rack-ten-compute/10-inch-homelab-computer/README.md

# 🖥️ RACK-10 — Сервер для 10-дюймовой стойки

> **Компактный серверный компьютер, разработанный для установки в 10-дюймовые стойки. Идеальное решение для хоум-лаб, edge-вычислений, NAS и домашней автоматизации.**




---

## 📋 Содержание

- [Описание](#-описание)
- [Области применения](#-основные-области-применения)
- [Технические характеристики](#-технические-характеристики)
- [Конфигурации](#-конфигурации)
- [Компоненты](#-компоненты)
- [Дорожная карта](#-дорожная-карта)
- [Лицензия](#-лицензия)

---

## 💡 Описание

**RACK-10** — это проект по разработке компактного серверного компьютера форм-фактора 10" (254 мм по ширине), который монтируется в стандартную 10-дюймовую раму (стойку). Устройство создано для энтузиастов, которым нужна производительная, но компактная вычислительная система для дома.

В отличие от громоздких 19-дюймовых серверов, RACK-10:

- Занимает вдвое меньше места по ширине
- Вписывается в интерьер (помещается в полку IKEA KALLAX)
- Сохраняет полную совместимость с сетевым и серверным оборудованием 10" формата

---

## 🎯 Основные области применения

| Область | Примеры использования |
|---|---|
| 🏠 **Хоум-лаб** | Кластер Proxmox, виртуализация, обучение |
| 💾 **NAS** | Домашнее облако, медиатека, бэкапы |
| 🔒 **Edge-вычисления** | Локальный AI, Frigate NVR, Coral TPU |
| 🏡 **Домашняя автоматизация** | Home Assistant, Zigbee/MQTT-брокер |
| 🌐 **Сетевая инфраструктура** | OPNsense/pfSense, роутер, DNS-сервер |

---

## 📐 Технические характеристики

| Параметр | Значение |
|---|---|
| **Форм-фактор** | 10" (совместимость с EIA-310) |
| **Ширина** | 254 мм (по стандарту) |
| **Высота** | 1U / 2U / 3U (на выбор) |
| **Глубина** | от 180 до 300 мм |
| **Платформа** | Advantech SOM-5871 — COM Express Basic Type 6, AMD Ryzen Embedded V1000 |
| **Охлаждение** | Активное / Пассивное (в зависимости от TDP) |
| **Питание** | DC 12V / 19V или ATX (PicoPSU) |

---

## 🚀 Конфигурации

Все конфигурации строятся на вычислительном модуле **Advantech SOM-5871**
(COM Express Basic Type 6) — AMD Ryzen Embedded V1000. Конфигурация меняется
выбором CPU (артикул модуля), ОЗУ и накопителей; несущая плата одна.

| Конфигурация | Модуль (CPU) | Ядер/потоков | TDP | ОЗУ |
|---|---|:---:|:---:|-----|
| **Эко (пассивное охлаждение)** | SOM-5871VC-U0A1 (V1605B) | 4/8 | 12–25 Вт | до 32 ГБ DDR4 |
| **Средняя** | SOM-5871VC-U3A1 (V1202B) / SOM-5871VCX-U1A1 (V1404I) | 2/4, 4/8 | 12–25 Вт | до 32 ГБ DDR4 |
| **Максимальная** | SOM-5871VC-H3A1 (V1807B) / SOM-5871VC-H2A1 (V1756B) | 4/8 | 35–54 Вт | до 32 ГБ DDR4 |

Общее для всех конфигураций:

- 2× SATA III (M.2 2280 Key B + U.2), PCIe x4 под NVMe/U.2 и x1 под M.2 M-Key
- 2× USB 3.1 Gen2 + 1× USB 3.1 Gen1 (все Type-A, Gen1 — с портом USB 2.0), 4× USB 2.0
- GbE (Intel I210-AT), dual-channel LVDS (2× FPC-40) + DisplayPort
- SMBus / I2C / SPI / WDT / FAN / GPIO — сервисные хедеры
- Питание: Vin 8.5–20 В (+ VSB 4.75–5.25 В в режиме ATX)

Подробности по интерфейсам — в [hw/README.md](hw/README.md).

---

## 🔧 Компоненты

- **Вычислительный модуль** — Advantech SOM-5871 (COM Express Basic Type 6,
  AMD Ryzen Embedded V1000), крепление — разъём COM Express Type 6
  (Molex [3-1827253-6](hw/bom/connectors/comexpress/3-1827253-6.pdf))
- **Несущая плата** — кастомная: M.2 2280 Key B, U.2, M.2 M-Key, 2× FPC-40
  (LVDS), RJ45, USB Type-A, HD Audio, сервисные пин-хедеры
  (GPIO/SPI/I2C/COM2)
- **ОЗУ** — 2× DDR4 SO-DIMM (на самом модуле)
- **Корпус** — 10" (254 мм), крепление в стойку EIA-310
- **Передняя панель** — опционально: порты USB, кнопка питания, LED-индикация
- **BOM** — каталог компонентов несущей платы: [hw/bom/README.md](hw/bom/README.md)

---

## 🗺️ Дорожная карта

- [x] Выбор вычислительного модуля (SOM-5871, AMD Ryzen Embedded V1000)
- [x] Спецификация интерфейсов несущей платы (сторона A/B и C/D)
- [x] BOM-каталог компонентов (первый компонент: разъём COM Express)
- [ ] Разработка несущей платы (схематика, разводка PCB)
- [ ] Прототип: SOM-5871VC-U0A1 + несущая плата
- [ ] Корпус 10" (CAD, 3D-печать / штамповка), крепление в стойку
- [ ] Блок питания (Vin 12–19 В, VSB)
- [ ] BIOS/UEFI-настройки, прошивки
- [ ] Файлы для 3D-печати корпуса (STL/STEP)
- [ ] Документация по сборке и эксплуатации

---

## Документация

- [docs/README.md](docs/README.md) — общая папка с доками;
  [docs/SOM-5871/README.md](docs/SOM-5871/README.md) — даташиты, user manual,
  application note, драйверы Windows 10, 3D-модели SOM-5871 + референсная плата
  SOM-DB5830 (схема, спецификация, разводка USB)

---

## 📄 Лицензия

Проект распространяется под лицензией MIT. Подробнее в файле [LICENSE](./LICENSE).

---

*Создано для энтузиастов хоум-лаб, DIY-сообщества и всех, кто хочет компактный сервер для дома*
