rack-ten-compute/10-inch-homelab-computer/hw/elec/README.md

# SOM-5871 — Электрическая спецификация

Источники:
- раздел **4 Electrical Characteristics** (Table 63–65) из
  [`docs/SOM-5871/design/SOM-5871 COM Express Type 6 Design Guide Rev110_220708.pdf`](../docs/SOM-5871/design/SOM-5871%20COM%20Express%20Type%206%20Design%20Guide%20Rev110_220708.pdf)
  — специфичен для SOM-5871;
- вкладка *Electrical Specifications* из
  [`docs/SOM-5871/design/SOM-5871 A101-3 COME Layout Checklist V1.01 20200604.xlsx`](../docs/SOM-5871/design/SOM-5871%20A101-3%20COME%20Layout%20Checklist%20V1.01%2020200604.xlsx)
  — общие требования COM Express Type 6 (440-pin): токи пинов,
  последовательность включения, время нарастания, целостность сигналов.

## Вводное питание

- Единственная основная шина — **+12 В** (номинал), допустимый диапазон
  **8,5–20 В** (Design Guide, Table 63: 8,5 = 9−5 % … 20 = 19+5 %).
- **+5 В standby (VCC_5V_SBY)** — может быть не подключена на несущей плате,
  если standby-функции не требуются.
- **+3 В батарея (VCC_RTC)** — питает RTC при отсутствии остальных источников;
  может быть оставлена незаземлённой, если RTC без питания не требуется.
- Переключение +5 В (non-standby) ATX-блока под модуль **не используется**
  (может применяться для остального оборудования несущей платы).
- Режимы питания: **ATX** (Vin + VSB) и **AT** (только Vin) — по
  спецификации SOM-DB5830; для ATX VSB обязательна.

Ограничения по току на пинах разъёма (Pin-out Type 2–56, 440 pin — актуально
для SOM-5871; Layout Checklist):

| Шина | Ток пина (А) | Номинал (В) | Диапазон входа (В) | Derated вход (В) | Макс. пульсации (мВ) | Макс. входная мощность (Вт) | КПД конверсии | Макс. мощность нагрузки (Вт) |
|:-----|:---:|:---:|:---:|:---:|:---:|:---:|:---:|:---:|
| VCC_12V | 16,5 | 12 | 11,4–12,6 | 11,4 | ±100 | 188 | 85 % | 160 |
| VCC_5V_SBY | 2 | 5 | 4,75–5,25 | 4,75 | ±50 | 9 | — | — |
| VCC_RTC | 0,5 | 3 | 2,0–3,3 | — | ±20 | — | — | — |

## Пределы абсолютных максимумов (Design Guide, Table 63)

| Параметр | MIN | MAX | Ед. |
|:---|:---:|:---:|:---:|
| VIN | 8,5 (9−5 %) | 20 (19+5 %) | В |
| VSB | 4,75 (5−5 %) | 5,25 (5+5 %) | В |
| RTC Battery | 2,4 | 3,3 | В |

## Потребление (Design Guide, Table 64)

Наихудший случай — V1807B (3.35 ГГц):

| Шина | S0 (TAT turbo, CPU 80 % + GPU 100 %) | S0 (Idle) | S3 | S5 | G3 |
|:-----|:---:|:---:|:--:|:--:|:--:|
| +VIN @ +12 В | 66,35 Вт | 11,14 Вт | — | — | — |
| +VIN @ +8,5 В | 64,32 Вт | 12,14 Вт | — | — | — |
| +VIN @ +20 В | 67,12 Вт | 15,00 Вт | — | — | — |
| +V5SB_CB | — | — | 1,34 Вт | 0,96 Вт | — |
| RTC Battery | — | — | — | — | 4,82 мкА |

> Примечание: S0 — режим Intel TAT, CPU All 100 % Turbo On.

## Ударные токи (Design Guide, Table 65)

| Шина | G3 → S5 (А) | S5 → S0 (А) |
|:-----|:---:|:---:|
| +V5SB_CB | 1,04 | — |
| +VIN @ +12 В | — | 5,20 |
| +VIN @ +8,5 В | — | 7,40 |
| +VIN @ +20 В | — | 3,27 |

> Блок питания несущей платы и предохранители подбирать с учётом
> максимального ударного тока 7,4 А (при питании 8,5 В).

## Последовательность включения (power sequencing)

- VCC_RTC — включается одновременно с VCC_5V_SBY или раньше.
- VCC_5V_SBY — одновременно с VCC_12V или раньше.
- PWR_OK — активен одновременно с VCC_12V или позже.
- Падение: PWR_OK сбрасывается одновременно с VCC_12V или раньше;
  VCC_12V — одновременно с VCC_5V_SBY или раньше; VCC_5V_SBY — одновременно
  с VCC_RTC или раньше.

| Т | Интервал | Требование |
|:-:|:---|:---|
| T1 | включение VCC_RTC → включение VCC_5V_SBY | ≥ 0 мс |
| T2 | включение VCC_5V_SBY → включение VCC_12V | ≥ 0 мс |
| T3 | включение VCC_12V → PWR_OK | ≥ 0 мс |
| T4 | сброс PWR_OK → сброс VCC_12V | ≥ 0 мс |
| T5 | сброс VCC_12V → сброс VCC_5V_SBY | ≥ 0 мс |
| T6 | сброс VCC_5V_SBY → сброс VCC_RTC | ≥ 0 мс |

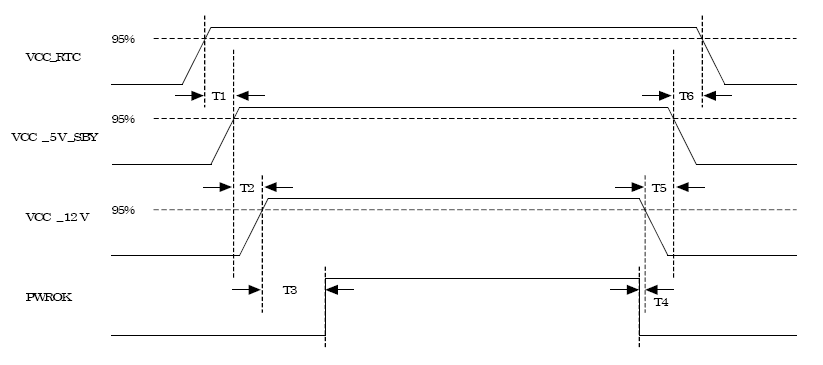
[picture p5: hw/elec/elec-power-sequencing.png]
Power Sequencing


## Время нарастания питающих напряжений

VCC_12V и VCC_5V_SBY (если используется) должны нарастать с ≤ 10 % номинала
до рабочего диапазона за **0,1–20 мс** (0,1 мс ≤ T1 ≤ 20 мс):

- плавный непрерывный фронт 10–90 % в пределах рабочего диапазона;
- на участке 10–90 % наклон положительный: от 0 В/мс до [Vout,nom / 0,1] В/мс;
- на любом участке 5 мс внутри фронта 10–90 % наклон ≥ [Vout,nom / 20] В/мс.

T2 ≥ 0 мс, T3 ≥ 0 мс. Значения подобраны для совместимости с ATX R2.2.

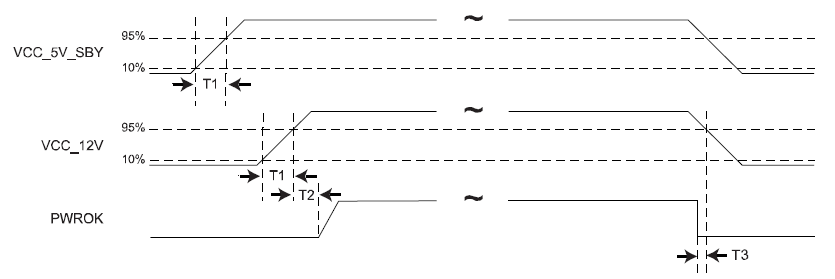
[picture p6: hw/elec/elec-power-rise-time.png]
Input Power Rise Time


## Требования к целостности сигналов

Для проектирования модуля и несущей платы учесть следующие группы сигналов
(полные требования — в соответствующих спецификациях интерфейсов):

| Группа сигналов | Описание | Источник |
|:---|:---|:---|
| Аналоговый VGA | 75 Ом, однополярные относительно GND; рекомендуется обильная изоляция | — |
| Компонентное/композитное видео | 75 Ом, однополярные относительно GND; рекомендуется обильная изоляция | — |
| Gigabit Ethernet | дифференциальные пары | IEEE 802.3 |
| LVDS | 100 Ом, edge-coupled дифференциальные пары | National Semiconductor LVDS |
| PCI Bus | ~60 Ом, однополярные | PCI SIG, PCI Local Bus Spec Rev. 2.3 |
| Часы PCI/LPC | 50 Ом, однополярные относительно GND | — |
| PCI Express | дифференциальные пары | PCI SIG, PCI Express Specification |
| Часы PCI Express | 100 Ом, edge-coupled дифференциальная пара, относительно GND | — |
| Serial ATA | дифференциальные пары | SATA Specification |
| USB | дифференциальные пары | USB 2.0 Specification |

> **Примечание:** VGA на SOM-5871 не выводится на несущую плату
> (см. [../pinout.md](../pinout.md), сводку по группам) — требования по VGA
> актуальны только для модуля.
