rack-ten-compute/10-inch-homelab-computer/hw/sch/pinout/comexpress-abcd.md

[FILE A]
A1 - GND_FIXED_1
A2 - GBE0_MDI3-
A3 - GBE0_MDI3+
A4 - GBE0_LINK100#
A5 - GBE0_LINK1000#
A6 - GBE0_MDI2-
A7 - GBE0_MDI2+
A8 - GBE0_LINK#
A9 - GBE0_MDI1-
A10 - GBE0_MDI1+
A11 - GND_FIXED_2
A12 - GBE0_MDI0-
A13 - GBE0_MDI0+
A14 - GBE0_CTREF
A15 - SUS_S3#
A16 - SATA0_TX+
A17 - SATA0_TX-
A18 - SUS_S4#
A19 - SATA0_RX+
A20 - SATA0_RX-
A21 - GND_FIXED_3
A22 - SATA2_TX+
A23 - SATA2_TX-
A24 - SUS_S5#
A25 - SATA2_RX+
A26 - SATA2_RX-
A27 - BATLOW#
A28 - SATA_ACT#
A29 - HDA_SYNC
A30 - HDA_RST#
A31 - GND_FIXED_4
A32 - HDA_BITCLK
A33 - HDA_SDOUT
A34 - BIOS_DIS0#/ESPI_SAFS
A35 - THRMTRIP#
A36 - USB6-
A37 - USB6+
A38 - USB_6_7_OC#
A39 - USB4-
A40 - USB4+
A41 - GND_FIXED_5
A42 - USB2-
A43 - USB2+
A44 - USB_2_3_OC#
A45 - USB0-
A46 - USB0+
A47 - VCC_RTC
A48 - RSMRST_OUT#
A49 - GBE0_SDP
A50 - LPC_SERIRQ/ESPI_CS1#
A51 - GND_FIXED_6
A52 - PCIE_TX5+
A53 - PCIE_TX5-
A54 - GPI0
A55 - PCIE_TX4+
A56 - PCIE_TX4-
A57 - GND_1
A58 - PCIE_TX3+
A59 - PCIE_TX3-
A60 - GND_FIXED_7
A61 - PCIE_TX2+
A62 - PCIE_TX2-
A63 - GPI1
A64 - PCIE_TX1+
A65 - PCIE_TX1-
A66 - GND_10
A67 - GPI2
A68 - PCIE_TX0+
A69 - PCIE_TX0-
A70 - GND_FIXED_8
A71 - LVDS_A0+
A72 - LVDS_A0-
A73 - LVDS_A1+
A74 - LVDS_A1-
A75 - LVDS_A2+
A76 - LVDS_A2-
A77 - LVDS_VDD_EN
A78 - LVDS_A3+
A79 - LVDS_A3-
A80 - GND_FIXED_9
A81 - LVDS_A_CK+
A82 - LVDS_A_CK-
A83 - LVDS_I2C_CK
A84 - LVDS_I2C_DAT
A85 - GPI3
A86 - GP_SPI_MOSI
A87 - EDP_HPD
A88 - PCIE_CK_REF+
A89 - PCIE_CK_REF-
A90 - GND_FIXED_10
A91 - SPI_POWER
A92 - SPI_MISO
A93 - GPO0
A94 - SPI_CLK
A95 - SPI_MOSI
A96 - TPM_PP
A97 - TYPE10#
A98 - SER0_TX
A99 - SER0_RX
A100 - GND_FIXED_11
A101 - SER1_TX
A102 - SER1_RX
A103 - LID#
A104 - VCC_12V_1
A105 - VCC_12V_2
A106 - VCC_12V_3
A107 - VCC_12V_4
A108 - VCC_12V_5
A109 - VCC_12V_6
A110 - GND_FIXED_12

[FILE B]
B1 - GND_FIXED_13
B2 - GBE0_ACT#
B3 - LPC_FRAME#/ESPI_CS0#
B4 - LPC_AD0/ESPI_IO_0
B5 - LPC_AD1/ESPI_IO_1
B6 - LPC_AD2/ESPI_IO_2
B7 - LPC_AD3/ESPI_IO_3
B8 - LPC_DRQ0#/ESPI_ALERT0#
B9 - LPC_DRQ1#/ESPI_ALERT1#
B10 - LPC_CLK/ESPI_CK
B11 - GND_FIXED_14
B12 - PWRBTN#
B13 - SMB_CK
B14 - SMB_DAT
B15 - SMB_ALERT#
B16 - SATA1_TX+
B17 - SATA1_TX-
B18 - SUS_STAT#/ESPI_RESET#
B19 - SATA1_RX+
B20 - SATA1_RX-
B21 - GND_FIXED_15
B22 - SATA3_TX+
B23 - SATA3_TX-
B24 - PWR_OK
B25 - SATA3_RX+
B26 - SATA3_RX-
B27 - WDT
B28 - HDA_SDIN2/SNDW0_CLK
B29 - HDA_SDIN1/SNDW0_DAT
B30 - HDA_SDIN0
B31 - GND_FIXED_16
B32 - SPKR
B33 - I2C_CK
B34 - I2C_DAT
B35 - THRM#
B36 - USB7-
B37 - USB7+
B38 - USB_4_5_OC#
B39 - USB5-
B40 - USB5+
B41 - GND_FIXED_17
B42 - USB3-
B43 - USB3+
B44 - USB_0_1_OC#
B45 - USB1-
B46 - USB1+
B47 - ESPI_EN#
B48 - USB0_HOST_PRSNT
B49 - SYS_RESET#
B50 - CB_RESET#
B51 - GND_FIXED_18
B52 - PCIE_RX5+
B53 - PCIE_RX5-
B54 - GPO1
B55 - PCIE_RX4+
B56 - PCIE_RX4-
B57 - GPO2
B58 - PCIE_RX3+
B59 - PCIE_RX3-
B60 - GND_FIXED_19
B61 - PCIE_RX2+
B62 - PCIE_RX2-
B63 - GPO3
B64 - PCIE_RX1+
B65 - PCIE_RX1-
B66 - WAKE0#
B67 - WAKE1#
B68 - PCIE_RX0+
B69 - PCIE_RX0-
B70 - GND_FIXED_20
B71 - LVDS_B0+
B72 - LVDS_B0-
B73 - LVDS_B1+
B74 - LVDS_B1-
B75 - LVDS_B2+
B76 - LVDS_B2-
B77 - LVDS_B3+
B78 - LVDS_B3-
B79 - LVDS_BKLT_EN
B80 - GND_FIXED_21
B81 - LVDS_B_CK+
B82 - LVDS_B_CK-
B83 - LVDS_BKLT_CTRL
B84 - VCC_5V_SBY_1
B85 - VCC_5V_SBY_2
B86 - VCC_5V_SBY_3
B87 - VCC_5V_SBY_4
B88 - BIOS_DIS1#
B89 - VGA_RED
B90 - GND_FIXED_22
B91 - VGA_GRN
B92 - VGA_BLU
B93 - VGA_HSYNC
B94 - VGA_VSYNC
B95 - VGA_I2C_CK
B96 - VGA_I2C_DAT
B97 - SPI_CS#
B98 - GP_SPI_MISO
B99 - GP_SPI_CK
B100 - GND_FIXED_23
B101 - FAN_PWMOUT
B102 - FAN_TACHIN
B103 - SLEEP#
B104 - VCC_12V_7
B105 - VCC_12V_8
B106 - VCC_12V_9
B107 - VCC_12V_10
B108 - VCC_12V_11
B109 - VCC_12V_12
B110 - GND_FIXED_24

[FILE C]
C1 - GND_FIXED_25
C2 - GND_11
C3 - USB_SSRX0-
C4 - USB_SSRX0+
C5 - GND_12
C6 - USB_SSRX1-
C7 - USB_SSRX1+
C8 - GND_13
C9 - USB_SSRX2-
C10 - USB_SSRX2+
C11 - GND_FIXED_26
C12 - USB_SSRX3-
C13 - USB_SSRX3+
C14 - GND_14
C15 - USB4_1_LSTX
C16 - USB4_1_LSRX
C17 - USB4_RT_ENA
C18 - GND_15
C19 - PCIE_RX6+
C20 - PCIE_RX6-
C21 - GND_FIXED_27
C22 - PCIE_RX7+
C23 - PCIE_RX7-
C24 - DDI1_HPD
C25 - SML0_CLK
C26 - SML0_DAT
C27 - SML1_CLK
C28 - SML1_DAT
C29 - USB4_PD_I2C_CLK
C30 - USB4_PD_I2C_DAT
C31 - GND_FIXED_28
C32 - DDI2_CTRLCLK_AUX+/USB4_2_AUX+
C33 - DDI2_CTRLDATA_AUX-/USB4_2_AUX-
C34 - DDI2_DDC_AUX_SEL
C35 - USB4_2_LSTX
C36 - DDI3_CTRLCLK_AUX+
C37 - DDI3_CTRLDATA_AUX-
C38 - DDI3_DDC_AUX_SEL
C39 - DDI3_PAIR0+
C40 - DDI3_PAIR0-
C41 - GND_FIXED_29
C42 - DDI3_PAIR1+
C43 - DDI3_PAIR1-
C44 - DDI3_HPD
C45 - GP_SPI_CS#
C46 - DDI3_PAIR2+
C47 - DDI3_PAIR2-
C48 - RSVD10_10
C49 - DDI3_PAIR3+
C50 - DDI3_PAIR3-
C51 - GND_FIXED_30
C52 - PEG_RX0+
C53 - PEG_RX0-
C54 - TYPE0#
C55 - PEG_RX1+
C56 - PEG_RX1-
C57 - TYPE1#
C58 - PEG_RX2+
C59 - PEG_RX2-
C60 - GND_FIXED_31
C61 - PEG_RX3+
C62 - PEG_RX3-
C63 - GND_3
C64 - GND_30
C65 - PEG_RX4+
C66 - PEG_RX4-
C67 - RAPID_SHUTDOWN
C68 - PEG_RX5+
C69 - PEG_RX5-
C70 - GND_FIXED_32
C71 - PEG_RX6+
C72 - PEG_RX6-
C73 - GND_31
C74 - PEG_RX7+
C75 - PEG_RX7-
C76 - GND_32
C77 - GND_33
C78 - PEG_RX8+
C79 - PEG_RX8-
C80 - GND_FIXED_33
C81 - PEG_RX9+
C82 - PEG_RX9-
C83 - GND_34
C84 - GND_35
C85 - PEG_RX10+
C86 - PEG_RX10-
C87 - GND_36
C88 - PEG_RX11+
C89 - PEG_RX11-
C90 - GND_FIXED_34
C91 - PEG_RX12+
C92 - PEG_RX12-
C93 - GND_37
C94 - PEG_RX13+
C95 - PEG_RX13-
C96 - GND_38
C97 - GND_39
C98 - PEG_RX14+
C99 - PEG_RX14-
C100 - GND_FIXED_35
C101 - PEG_RX15+
C102 - PEG_RX15-
C103 - GND_8
C104 - VCC_12V_13
C105 - VCC_12V_14
C106 - VCC_12V_15
C107 - VCC_12V_16
C108 - VCC_12V_17
C109 - VCC_12V_18
C110 - GND_FIXED_36

[FILE D]
D1 - GND_FIXED_37
D2 - GND_16
D3 - USB_SSTX0-
D4 - USB_SSTX0+
D5 - GND_17
D6 - USB_SSTX1-
D7 - USB_SSTX1+
D8 - GND_18
D9 - USB_SSTX2-
D10 - USB_SSTX2+
D11 - GND_FIXED_38
D12 - USB_SSTX3-
D13 - USB_SSTX3+
D14 - GND_19
D15 - DDI1_CTRLCLK_AUX+/USB4_1_AUX+
D16 - DDI1_CTRLDATA_AUX-/USB4_1_AUX-
D17 - USB4_PD_I2C_ALERT#
D18 - PMCALERT#
D19 - PCIE_TX6+
D20 - PCIE_TX6-
D21 - GND_FIXED_39
D22 - PCIE_TX7+
D23 - PCIE_TX7-
D24 - GND_2
D25 - GND_20
D26 - DDI1_PAIR0+/USB4_1_SSTX0+
D27 - DDI1_PAIR0-/USB4_1_SSTX0-
D28 - RSVD10_20
D29 - DDI1_PAIR1+/USB4_1_SSRX0+
D30 - DDI1_PAIR1-/USB4_1_SSRX0-
D31 - GND_FIXED_40
D32 - DDI1_PAIR2+/USB4_1_SSTX1+
D33 - DDI1_PAIR2-/USB4_1_SSTX1-
D34 - DDI1_DDC_AUX_SEL
D35 - USB4_2_LSRX
D36 - DDI1_PAIR3+/USB4_1_SSRX1+
D37 - DDI1_PAIR3-/USB4_1_SSRX1-
D38 - GND_21
D39 - DDI2_PAIR0+/USB4_2_SSTX0+
D40 - DDI2_PAIR0-/USB4_2_SSTX0-
D41 - GND_FIXED_41
D42 - DDI2_PAIR1+/USB4_2_SSRX0+
D43 - DDI2_PAIR1-/USB4_2_SSRX0-
D44 - DDI2_HPD
D45 - GND_22
D46 - DDI2_PAIR2+/USB4_2_SSTX1+
D47 - DDI2_PAIR2-/USB4_2_SSTX1-
D48 - GND_23
D49 - DDI2_PAIR3+/USB4_2_SSRX1+
D50 - DDI2_PAIR3-/USB4_2_SSRX1-
D51 - GND_FIXED_42
D52 - PEG_TX0+
D53 - PEG_TX0-
D54 - PEG_LANE_RV#
D55 - PEG_TX1+
D56 - PEG_TX1-
D57 - TYPE2#
D58 - PEG_TX2+
D59 - PEG_TX2-
D60 - GND_FIXED_43
D61 - PEG_TX3+
D62 - PEG_TX3-
D63 - GND_24
D64 - GND_25
D65 - PEG_TX4+
D66 - PEG_TX4-
D67 - GND_26
D68 - PEG_TX5+
D69 - PEG_TX5-
D70 - GND_FIXED_44
D71 - PEG_TX6+
D72 - PEG_TX6-
D73 - GND_27
D74 - PEG_TX7+
D75 - PEG_TX7-
D76 - GND_28
D77 - GND_29
D78 - PEG_TX8+
D79 - PEG_TX8-
D80 - GND_FIXED_45
D81 - PEG_TX9+
D82 - PEG_TX9-
D83 - GND_4
D84 - GND_40
D85 - PEG_TX10+
D86 - PEG_TX10-
D87 - GND_41
D88 - PEG_TX11+
D89 - PEG_TX11-
D90 - GND_FIXED_46
D91 - PEG_TX12+
D92 - PEG_TX12-
D93 - GND_5
D94 - PEG_TX13+
D95 - PEG_TX13-
D96 - GND_6
D97 - GND_7
D98 - PEG_TX14+
D99 - PEG_TX14-
D100 - GND_FIXED_47
D101 - PEG_TX15+
D102 - PEG_TX15-
D103 - GND_9
D104 - VCC_12V_19
D105 - VCC_12V_20
D106 - VCC_12V_21
D107 - VCC_12V_22
D108 - VCC_12V_23
D109 - VCC_12V_24
D110 - GND_FIXED_48
