rack-ten-compute/10-inch-homelab-computer/docs/SOM-5871/win10-driver/cloud-mail-link.md

https://cloud.mail.ru/public/WeKb/FmAMsSqu3
https://www.advantech.com/emt/support/details/driver-?id=1-1P332Z7
