rack-ten-compute/10-inch-homelab-computer/hw/sch/pinout/comexpress-abcd-pinout.xlsx

Sheet: A
Pin | Ball | Type | Side
GND_FIXED_1 | A1 | GND | LEFT
GBE0_MDI3- | A2 | BIDIR | LEFT
GBE0_MDI3+ | A3 | BIDIR | LEFT
GBE0_LINK100# | A4 | BIDIR | LEFT
GBE0_LINK1000# | A5 | BIDIR | LEFT
GBE0_MDI2- | A6 | BIDIR | LEFT
GBE0_MDI2+ | A7 | BIDIR | LEFT
GBE0_LINK# | A8 | BIDIR | LEFT
GBE0_MDI1- | A9 | BIDIR | LEFT
GBE0_MDI1+ | A10 | BIDIR | LEFT
GND_FIXED_2 | A11 | GND | LEFT
GBE0_MDI0- | A12 | BIDIR | LEFT
GBE0_MDI0+ | A13 | BIDIR | LEFT
GBE0_CTREF | A14 | BIDIR | LEFT
SUS_S3# | A15 | BIDIR | LEFT
SATA0_TX+ | A16 | BIDIR | LEFT
SATA0_TX- | A17 | BIDIR | LEFT
SUS_S4# | A18 | BIDIR | LEFT
SATA0_RX+ | A19 | BIDIR | LEFT
SATA0_RX- | A20 | BIDIR | LEFT
GND_FIXED_3 | A21 | GND | LEFT
SATA2_TX+ | A22 | BIDIR | LEFT
SATA2_TX- | A23 | BIDIR | LEFT
SUS_S5# | A24 | BIDIR | LEFT
SATA2_RX+ | A25 | BIDIR | LEFT
SATA2_RX- | A26 | BIDIR | LEFT
BATLOW# | A27 | BIDIR | LEFT
SATA_ACT# | A28 | BIDIR | LEFT
HDA_SYNC | A29 | BIDIR | LEFT
HDA_RST# | A30 | BIDIR | LEFT
GND_FIXED_4 | A31 | GND | LEFT
HDA_BITCLK | A32 | BIDIR | LEFT
HDA_SDOUT | A33 | BIDIR | LEFT
BIOS_DIS0#/ESPI_SAFS | A34 | BIDIR | LEFT
THRMTRIP# | A35 | BIDIR | LEFT
USB6- | A36 | BIDIR | LEFT
USB6+ | A37 | BIDIR | LEFT
USB_6_7_OC# | A38 | BIDIR | LEFT
USB4- | A39 | BIDIR | LEFT
USB4+ | A40 | BIDIR | LEFT
GND_FIXED_5 | A41 | GND | LEFT
USB2- | A42 | BIDIR | LEFT
USB2+ | A43 | BIDIR | LEFT
USB_2_3_OC# | A44 | BIDIR | LEFT
USB0- | A45 | BIDIR | LEFT
USB0+ | A46 | BIDIR | LEFT
VCC_RTC | A47 | PWR | LEFT
RSMRST_OUT# | A48 | BIDIR | LEFT
GBE0_SDP | A49 | BIDIR | LEFT
LPC_SERIRQ/ESPI_CS1# | A50 | BIDIR | LEFT
GND_FIXED_6 | A51 | GND | LEFT
PCIE_TX5+ | A52 | BIDIR | LEFT
PCIE_TX5- | A53 | BIDIR | LEFT
GPI0 | A54 | BIDIR | LEFT
PCIE_TX4+ | A55 | BIDIR | LEFT
PCIE_TX4- | A56 | BIDIR | LEFT
GND_1 | A57 | GND | LEFT
PCIE_TX3+ | A58 | BIDIR | LEFT
PCIE_TX3- | A59 | BIDIR | LEFT
GND_FIXED_7 | A60 | GND | LEFT
PCIE_TX2+ | A61 | BIDIR | LEFT
PCIE_TX2- | A62 | BIDIR | LEFT
GPI1 | A63 | BIDIR | LEFT
PCIE_TX1+ | A64 | BIDIR | LEFT
PCIE_TX1- | A65 | BIDIR | LEFT
GND_10 | A66 | GND | LEFT
GPI2 | A67 | BIDIR | LEFT
PCIE_TX0+ | A68 | BIDIR | LEFT
PCIE_TX0- | A69 | BIDIR | LEFT
GND_FIXED_8 | A70 | GND | LEFT
LVDS_A0+ | A71 | BIDIR | LEFT
LVDS_A0- | A72 | BIDIR | LEFT
LVDS_A1+ | A73 | BIDIR | LEFT
LVDS_A1- | A74 | BIDIR | LEFT
LVDS_A2+ | A75 | BIDIR | LEFT
LVDS_A2- | A76 | BIDIR | LEFT
LVDS_VDD_EN | A77 | BIDIR | LEFT
LVDS_A3+ | A78 | BIDIR | LEFT
LVDS_A3- | A79 | BIDIR | LEFT
GND_FIXED_9 | A80 | GND | LEFT
LVDS_A_CK+ | A81 | BIDIR | LEFT
LVDS_A_CK- | A82 | BIDIR | LEFT
LVDS_I2C_CK | A83 | BIDIR | LEFT
LVDS_I2C_DAT | A84 | BIDIR | LEFT
GPI3 | A85 | BIDIR | LEFT
GP_SPI_MOSI | A86 | BIDIR | LEFT
EDP_HPD | A87 | BIDIR | LEFT
PCIE_CK_REF+ | A88 | BIDIR | LEFT
PCIE_CK_REF- | A89 | BIDIR | LEFT
GND_FIXED_10 | A90 | GND | LEFT
SPI_POWER | A91 | BIDIR | LEFT
SPI_MISO | A92 | BIDIR | LEFT
GPO0 | A93 | BIDIR | LEFT
SPI_CLK | A94 | BIDIR | LEFT
SPI_MOSI | A95 | BIDIR | LEFT
TPM_PP | A96 | BIDIR | LEFT
TYPE10# | A97 | BIDIR | LEFT
SER0_TX | A98 | BIDIR | LEFT
SER0_RX | A99 | BIDIR | LEFT
GND_FIXED_11 | A100 | GND | LEFT
SER1_TX | A101 | BIDIR | LEFT
SER1_RX | A102 | BIDIR | LEFT
LID# | A103 | BIDIR | LEFT
VCC_12V_1 | A104 | PWR | LEFT
VCC_12V_2 | A105 | PWR | LEFT
VCC_12V_3 | A106 | PWR | LEFT
VCC_12V_4 | A107 | PWR | LEFT
VCC_12V_5 | A108 | PWR | LEFT
VCC_12V_6 | A109 | PWR | LEFT
GND_FIXED_12 | A110 | GND | LEFT

Sheet: B
Pin | Ball | Type | Side
GND_FIXED_13 | B1 | GND | RIGHT
GBE0_ACT# | B2 | BIDIR | RIGHT
LPC_FRAME#/ESPI_CS0# | B3 | BIDIR | RIGHT
LPC_AD0/ESPI_IO_0 | B4 | BIDIR | RIGHT
LPC_AD1/ESPI_IO_1 | B5 | BIDIR | RIGHT
LPC_AD2/ESPI_IO_2 | B6 | BIDIR | RIGHT
LPC_AD3/ESPI_IO_3 | B7 | BIDIR | RIGHT
LPC_DRQ0#/ESPI_ALERT0# | B8 | BIDIR | RIGHT
LPC_DRQ1#/ESPI_ALERT1# | B9 | BIDIR | RIGHT
LPC_CLK/ESPI_CK | B10 | BIDIR | RIGHT
GND_FIXED_14 | B11 | GND | RIGHT
PWRBTN# | B12 | BIDIR | RIGHT
SMB_CK | B13 | BIDIR | RIGHT
SMB_DAT | B14 | BIDIR | RIGHT
SMB_ALERT# | B15 | BIDIR | RIGHT
SATA1_TX+ | B16 | BIDIR | RIGHT
SATA1_TX- | B17 | BIDIR | RIGHT
SUS_STAT#/ESPI_RESET# | B18 | BIDIR | RIGHT
SATA1_RX+ | B19 | BIDIR | RIGHT
SATA1_RX- | B20 | BIDIR | RIGHT
GND_FIXED_15 | B21 | GND | RIGHT
SATA3_TX+ | B22 | BIDIR | RIGHT
SATA3_TX- | B23 | BIDIR | RIGHT
PWR_OK | B24 | BIDIR | RIGHT
SATA3_RX+ | B25 | BIDIR | RIGHT
SATA3_RX- | B26 | BIDIR | RIGHT
WDT | B27 | BIDIR | RIGHT
HDA_SDIN2/SNDW0_CLK | B28 | BIDIR | RIGHT
HDA_SDIN1/SNDW0_DAT | B29 | BIDIR | RIGHT
HDA_SDIN0 | B30 | BIDIR | RIGHT
GND_FIXED_16 | B31 | GND | RIGHT
SPKR | B32 | BIDIR | RIGHT
I2C_CK | B33 | BIDIR | RIGHT
I2C_DAT | B34 | BIDIR | RIGHT
THRM# | B35 | BIDIR | RIGHT
USB7- | B36 | BIDIR | RIGHT
USB7+ | B37 | BIDIR | RIGHT
USB_4_5_OC# | B38 | BIDIR | RIGHT
USB5- | B39 | BIDIR | RIGHT
USB5+ | B40 | BIDIR | RIGHT
GND_FIXED_17 | B41 | GND | RIGHT
USB3- | B42 | BIDIR | RIGHT
USB3+ | B43 | BIDIR | RIGHT
USB_0_1_OC# | B44 | BIDIR | RIGHT
USB1- | B45 | BIDIR | RIGHT
USB1+ | B46 | BIDIR | RIGHT
ESPI_EN# | B47 | BIDIR | RIGHT
USB0_HOST_PRSNT | B48 | BIDIR | RIGHT
SYS_RESET# | B49 | BIDIR | RIGHT
CB_RESET# | B50 | BIDIR | RIGHT
GND_FIXED_18 | B51 | GND | RIGHT
PCIE_RX5+ | B52 | BIDIR | RIGHT
PCIE_RX5- | B53 | BIDIR | RIGHT
GPO1 | B54 | BIDIR | RIGHT
PCIE_RX4+ | B55 | BIDIR | RIGHT
PCIE_RX4- | B56 | BIDIR | RIGHT
GPO2 | B57 | BIDIR | RIGHT
PCIE_RX3+ | B58 | BIDIR | RIGHT
PCIE_RX3- | B59 | BIDIR | RIGHT
GND_FIXED_19 | B60 | GND | RIGHT
PCIE_RX2+ | B61 | BIDIR | RIGHT
PCIE_RX2- | B62 | BIDIR | RIGHT
GPO3 | B63 | BIDIR | RIGHT
PCIE_RX1+ | B64 | BIDIR | RIGHT
PCIE_RX1- | B65 | BIDIR | RIGHT
WAKE0# | B66 | BIDIR | RIGHT
WAKE1# | B67 | BIDIR | RIGHT
PCIE_RX0+ | B68 | BIDIR | RIGHT
PCIE_RX0- | B69 | BIDIR | RIGHT
GND_FIXED_20 | B70 | GND | RIGHT
LVDS_B0+ | B71 | BIDIR | RIGHT
LVDS_B0- | B72 | BIDIR | RIGHT
LVDS_B1+ | B73 | BIDIR | RIGHT
LVDS_B1- | B74 | BIDIR | RIGHT
LVDS_B2+ | B75 | BIDIR | RIGHT
LVDS_B2- | B76 | BIDIR | RIGHT
LVDS_B3+ | B77 | BIDIR | RIGHT
LVDS_B3- | B78 | BIDIR | RIGHT
LVDS_BKLT_EN | B79 | BIDIR | RIGHT
GND_FIXED_21 | B80 | GND | RIGHT
LVDS_B_CK+ | B81 | BIDIR | RIGHT
LVDS_B_CK- | B82 | BIDIR | RIGHT
LVDS_BKLT_CTRL | B83 | BIDIR | RIGHT
VCC_5V_SBY_1 | B84 | PWR | RIGHT
VCC_5V_SBY_2 | B85 | PWR | RIGHT
VCC_5V_SBY_3 | B86 | PWR | RIGHT
VCC_5V_SBY_4 | B87 | PWR | RIGHT
BIOS_DIS1# | B88 | BIDIR | RIGHT
VGA_RED | B89 | BIDIR | RIGHT
GND_FIXED_22 | B90 | GND | RIGHT
VGA_GRN | B91 | BIDIR | RIGHT
VGA_BLU | B92 | BIDIR | RIGHT
VGA_HSYNC | B93 | BIDIR | RIGHT
VGA_VSYNC | B94 | BIDIR | RIGHT
VGA_I2C_CK | B95 | BIDIR | RIGHT
VGA_I2C_DAT | B96 | BIDIR | RIGHT
SPI_CS# | B97 | BIDIR | RIGHT
GP_SPI_MISO | B98 | BIDIR | RIGHT
GP_SPI_CK | B99 | BIDIR | RIGHT
GND_FIXED_23 | B100 | GND | RIGHT
FAN_PWMOUT | B101 | BIDIR | RIGHT
FAN_TACHIN | B102 | BIDIR | RIGHT
SLEEP# | B103 | BIDIR | RIGHT
VCC_12V_7 | B104 | PWR | RIGHT
VCC_12V_8 | B105 | PWR | RIGHT
VCC_12V_9 | B106 | PWR | RIGHT
VCC_12V_10 | B107 | PWR | RIGHT
VCC_12V_11 | B108 | PWR | RIGHT
VCC_12V_12 | B109 | PWR | RIGHT
GND_FIXED_24 | B110 | GND | RIGHT

Sheet: C
Pin | Ball | Type | Side
GND_FIXED_25 | C1 | GND | LEFT
GND_11 | C2 | GND | LEFT
USB_SSRX0- | C3 | BIDIR | LEFT
USB_SSRX0+ | C4 | BIDIR | LEFT
GND_12 | C5 | GND | LEFT
USB_SSRX1- | C6 | BIDIR | LEFT
USB_SSRX1+ | C7 | BIDIR | LEFT
GND_13 | C8 | GND | LEFT
USB_SSRX2- | C9 | BIDIR | LEFT
USB_SSRX2+ | C10 | BIDIR | LEFT
GND_FIXED_26 | C11 | GND | LEFT
USB_SSRX3- | C12 | BIDIR | LEFT
USB_SSRX3+ | C13 | BIDIR | LEFT
GND_14 | C14 | GND | LEFT
USB4_1_LSTX | C15 | BIDIR | LEFT
USB4_1_LSRX | C16 | BIDIR | LEFT
USB4_RT_ENA | C17 | BIDIR | LEFT
GND_15 | C18 | GND | LEFT
PCIE_RX6+ | C19 | BIDIR | LEFT
PCIE_RX6- | C20 | BIDIR | LEFT
GND_FIXED_27 | C21 | GND | LEFT
PCIE_RX7+ | C22 | BIDIR | LEFT
PCIE_RX7- | C23 | BIDIR | LEFT
DDI1_HPD | C24 | BIDIR | LEFT
SML0_CLK | C25 | BIDIR | LEFT
SML0_DAT | C26 | BIDIR | LEFT
SML1_CLK | C27 | BIDIR | LEFT
SML1_DAT | C28 | BIDIR | LEFT
USB4_PD_I2C_CLK | C29 | BIDIR | LEFT
USB4_PD_I2C_DAT | C30 | BIDIR | LEFT
GND_FIXED_28 | C31 | GND | LEFT
DDI2_CTRLCLK_AUX+/USB4_2_AUX+ | C32 | BIDIR | LEFT
DDI2_CTRLDATA_AUX-/USB4_2_AUX- | C33 | BIDIR | LEFT
DDI2_DDC_AUX_SEL | C34 | BIDIR | LEFT
USB4_2_LSTX | C35 | BIDIR | LEFT
DDI3_CTRLCLK_AUX+ | C36 | BIDIR | LEFT
DDI3_CTRLDATA_AUX- | C37 | BIDIR | LEFT
DDI3_DDC_AUX_SEL | C38 | BIDIR | LEFT
DDI3_PAIR0+ | C39 | BIDIR | LEFT
DDI3_PAIR0- | C40 | BIDIR | LEFT
GND_FIXED_29 | C41 | GND | LEFT
DDI3_PAIR1+ | C42 | BIDIR | LEFT
DDI3_PAIR1- | C43 | BIDIR | LEFT
DDI3_HPD | C44 | BIDIR | LEFT
GP_SPI_CS# | C45 | BIDIR | LEFT
DDI3_PAIR2+ | C46 | BIDIR | LEFT
DDI3_PAIR2- | C47 | BIDIR | LEFT
RSVD10_10 | C48 | BIDIR | LEFT
DDI3_PAIR3+ | C49 | BIDIR | LEFT
DDI3_PAIR3- | C50 | BIDIR | LEFT
GND_FIXED_30 | C51 | GND | LEFT
PEG_RX0+ | C52 | BIDIR | LEFT
PEG_RX0- | C53 | BIDIR | LEFT
TYPE0# | C54 | BIDIR | LEFT
PEG_RX1+ | C55 | BIDIR | LEFT
PEG_RX1- | C56 | BIDIR | LEFT
TYPE1# | C57 | BIDIR | LEFT
PEG_RX2+ | C58 | BIDIR | LEFT
PEG_RX2- | C59 | BIDIR | LEFT
GND_FIXED_31 | C60 | GND | LEFT
PEG_RX3+ | C61 | BIDIR | LEFT
PEG_RX3- | C62 | BIDIR | LEFT
GND_3 | C63 | GND | LEFT
GND_30 | C64 | GND | LEFT
PEG_RX4+ | C65 | BIDIR | LEFT
PEG_RX4- | C66 | BIDIR | LEFT
RAPID_SHUTDOWN | C67 | BIDIR | LEFT
PEG_RX5+ | C68 | BIDIR | LEFT
PEG_RX5- | C69 | BIDIR | LEFT
GND_FIXED_32 | C70 | GND | LEFT
PEG_RX6+ | C71 | BIDIR | LEFT
PEG_RX6- | C72 | BIDIR | LEFT
GND_31 | C73 | GND | LEFT
PEG_RX7+ | C74 | BIDIR | LEFT
PEG_RX7- | C75 | BIDIR | LEFT
GND_32 | C76 | GND | LEFT
GND_33 | C77 | GND | LEFT
PEG_RX8+ | C78 | BIDIR | LEFT
PEG_RX8- | C79 | BIDIR | LEFT
GND_FIXED_33 | C80 | GND | LEFT
PEG_RX9+ | C81 | BIDIR | LEFT
PEG_RX9- | C82 | BIDIR | LEFT
GND_34 | C83 | GND | LEFT
GND_35 | C84 | GND | LEFT
PEG_RX10+ | C85 | BIDIR | LEFT
PEG_RX10- | C86 | BIDIR | LEFT
GND_36 | C87 | GND | LEFT
PEG_RX11+ | C88 | BIDIR | LEFT
PEG_RX11- | C89 | BIDIR | LEFT
GND_FIXED_34 | C90 | GND | LEFT
PEG_RX12+ | C91 | BIDIR | LEFT
PEG_RX12- | C92 | BIDIR | LEFT
GND_37 | C93 | GND | LEFT
PEG_RX13+ | C94 | BIDIR | LEFT
PEG_RX13- | C95 | BIDIR | LEFT
GND_38 | C96 | GND | LEFT
GND_39 | C97 | GND | LEFT
PEG_RX14+ | C98 | BIDIR | LEFT
PEG_RX14- | C99 | BIDIR | LEFT
GND_FIXED_35 | C100 | GND | LEFT
PEG_RX15+ | C101 | BIDIR | LEFT
PEG_RX15- | C102 | BIDIR | LEFT
GND_8 | C103 | GND | LEFT
VCC_12V_13 | C104 | PWR | LEFT
VCC_12V_14 | C105 | PWR | LEFT
VCC_12V_15 | C106 | PWR | LEFT
VCC_12V_16 | C107 | PWR | LEFT
VCC_12V_17 | C108 | PWR | LEFT
VCC_12V_18 | C109 | PWR | LEFT
GND_FIXED_36 | C110 | GND | LEFT

Sheet: D
Pin | Ball | Type | Side
GND_FIXED_37 | D1 | GND | RIGHT
GND_16 | D2 | GND | RIGHT
USB_SSTX0- | D3 | BIDIR | RIGHT
USB_SSTX0+ | D4 | BIDIR | RIGHT
GND_17 | D5 | GND | RIGHT
USB_SSTX1- | D6 | BIDIR | RIGHT
USB_SSTX1+ | D7 | BIDIR | RIGHT
GND_18 | D8 | GND | RIGHT
USB_SSTX2- | D9 | BIDIR | RIGHT
USB_SSTX2+ | D10 | BIDIR | RIGHT
GND_FIXED_38 | D11 | GND | RIGHT
USB_SSTX3- | D12 | BIDIR | RIGHT
USB_SSTX3+ | D13 | BIDIR | RIGHT
GND_19 | D14 | GND | RIGHT
DDI1_CTRLCLK_AUX+/USB4_1_AUX+ | D15 | BIDIR | RIGHT
DDI1_CTRLDATA_AUX-/USB4_1_AUX- | D16 | BIDIR | RIGHT
USB4_PD_I2C_ALERT# | D17 | BIDIR | RIGHT
PMCALERT# | D18 | BIDIR | RIGHT
PCIE_TX6+ | D19 | BIDIR | RIGHT
PCIE_TX6- | D20 | BIDIR | RIGHT
GND_FIXED_39 | D21 | GND | RIGHT
PCIE_TX7+ | D22 | BIDIR | RIGHT
PCIE_TX7- | D23 | BIDIR | RIGHT
GND_2 | D24 | GND | RIGHT
GND_20 | D25 | GND | RIGHT
DDI1_PAIR0+/USB4_1_SSTX0+ | D26 | BIDIR | RIGHT
DDI1_PAIR0-/USB4_1_SSTX0- | D27 | BIDIR | RIGHT
RSVD10_20 | D28 | BIDIR | RIGHT
DDI1_PAIR1+/USB4_1_SSRX0+ | D29 | BIDIR | RIGHT
DDI1_PAIR1-/USB4_1_SSRX0- | D30 | BIDIR | RIGHT
GND_FIXED_40 | D31 | GND | RIGHT
DDI1_PAIR2+/USB4_1_SSTX1+ | D32 | BIDIR | RIGHT
DDI1_PAIR2-/USB4_1_SSTX1- | D33 | BIDIR | RIGHT
DDI1_DDC_AUX_SEL | D34 | BIDIR | RIGHT
USB4_2_LSRX | D35 | BIDIR | RIGHT
DDI1_PAIR3+/USB4_1_SSRX1+ | D36 | BIDIR | RIGHT
DDI1_PAIR3-/USB4_1_SSRX1- | D37 | BIDIR | RIGHT
GND_21 | D38 | GND | RIGHT
DDI2_PAIR0+/USB4_2_SSTX0+ | D39 | BIDIR | RIGHT
DDI2_PAIR0-/USB4_2_SSTX0- | D40 | BIDIR | RIGHT
GND_FIXED_41 | D41 | GND | RIGHT
DDI2_PAIR1+/USB4_2_SSRX0+ | D42 | BIDIR | RIGHT
DDI2_PAIR1-/USB4_2_SSRX0- | D43 | BIDIR | RIGHT
DDI2_HPD | D44 | BIDIR | RIGHT
GND_22 | D45 | GND | RIGHT
DDI2_PAIR2+/USB4_2_SSTX1+ | D46 | BIDIR | RIGHT
DDI2_PAIR2-/USB4_2_SSTX1- | D47 | BIDIR | RIGHT
GND_23 | D48 | GND | RIGHT
DDI2_PAIR3+/USB4_2_SSRX1+ | D49 | BIDIR | RIGHT
DDI2_PAIR3-/USB4_2_SSRX1- | D50 | BIDIR | RIGHT
GND_FIXED_42 | D51 | GND | RIGHT
PEG_TX0+ | D52 | BIDIR | RIGHT
PEG_TX0- | D53 | BIDIR | RIGHT
PEG_LANE_RV# | D54 | BIDIR | RIGHT
PEG_TX1+ | D55 | BIDIR | RIGHT
PEG_TX1- | D56 | BIDIR | RIGHT
TYPE2# | D57 | BIDIR | RIGHT
PEG_TX2+ | D58 | BIDIR | RIGHT
PEG_TX2- | D59 | BIDIR | RIGHT
GND_FIXED_43 | D60 | GND | RIGHT
PEG_TX3+ | D61 | BIDIR | RIGHT
PEG_TX3- | D62 | BIDIR | RIGHT
GND_24 | D63 | GND | RIGHT
GND_25 | D64 | GND | RIGHT
PEG_TX4+ | D65 | BIDIR | RIGHT
PEG_TX4- | D66 | BIDIR | RIGHT
GND_26 | D67 | GND | RIGHT
PEG_TX5+ | D68 | BIDIR | RIGHT
PEG_TX5- | D69 | BIDIR | RIGHT
GND_FIXED_44 | D70 | GND | RIGHT
PEG_TX6+ | D71 | BIDIR | RIGHT
PEG_TX6- | D72 | BIDIR | RIGHT
GND_27 | D73 | GND | RIGHT
PEG_TX7+ | D74 | BIDIR | RIGHT
PEG_TX7- | D75 | BIDIR | RIGHT
GND_28 | D76 | GND | RIGHT
GND_29 | D77 | GND | RIGHT
PEG_TX8+ | D78 | BIDIR | RIGHT
PEG_TX8- | D79 | BIDIR | RIGHT
GND_FIXED_45 | D80 | GND | RIGHT
PEG_TX9+ | D81 | BIDIR | RIGHT
PEG_TX9- | D82 | BIDIR | RIGHT
GND_4 | D83 | GND | RIGHT
GND_40 | D84 | GND | RIGHT
PEG_TX10+ | D85 | BIDIR | RIGHT
PEG_TX10- | D86 | BIDIR | RIGHT
GND_41 | D87 | GND | RIGHT
PEG_TX11+ | D88 | BIDIR | RIGHT
PEG_TX11- | D89 | BIDIR | RIGHT
GND_FIXED_46 | D90 | GND | RIGHT
PEG_TX12+ | D91 | BIDIR | RIGHT
PEG_TX12- | D92 | BIDIR | RIGHT
GND_5 | D93 | GND | RIGHT
PEG_TX13+ | D94 | BIDIR | RIGHT
PEG_TX13- | D95 | BIDIR | RIGHT
GND_6 | D96 | GND | RIGHT
GND_7 | D97 | GND | RIGHT
PEG_TX14+ | D98 | BIDIR | RIGHT
PEG_TX14- | D99 | BIDIR | RIGHT
GND_FIXED_47 | D100 | GND | RIGHT
PEG_TX15+ | D101 | BIDIR | RIGHT
PEG_TX15- | D102 | BIDIR | RIGHT
GND_9 | D103 | GND | RIGHT
VCC_12V_19 | D104 | PWR | RIGHT
VCC_12V_20 | D105 | PWR | RIGHT
VCC_12V_21 | D106 | PWR | RIGHT
VCC_12V_22 | D107 | PWR | RIGHT
VCC_12V_23 | D108 | PWR | RIGHT
VCC_12V_24 | D109 | PWR | RIGHT
GND_FIXED_48 | D110 | GND | RIGHT
