rack-ten-compute/10-inch-homelab-computer/hw/mech/pcie-card-bracket-dimensions.PNG

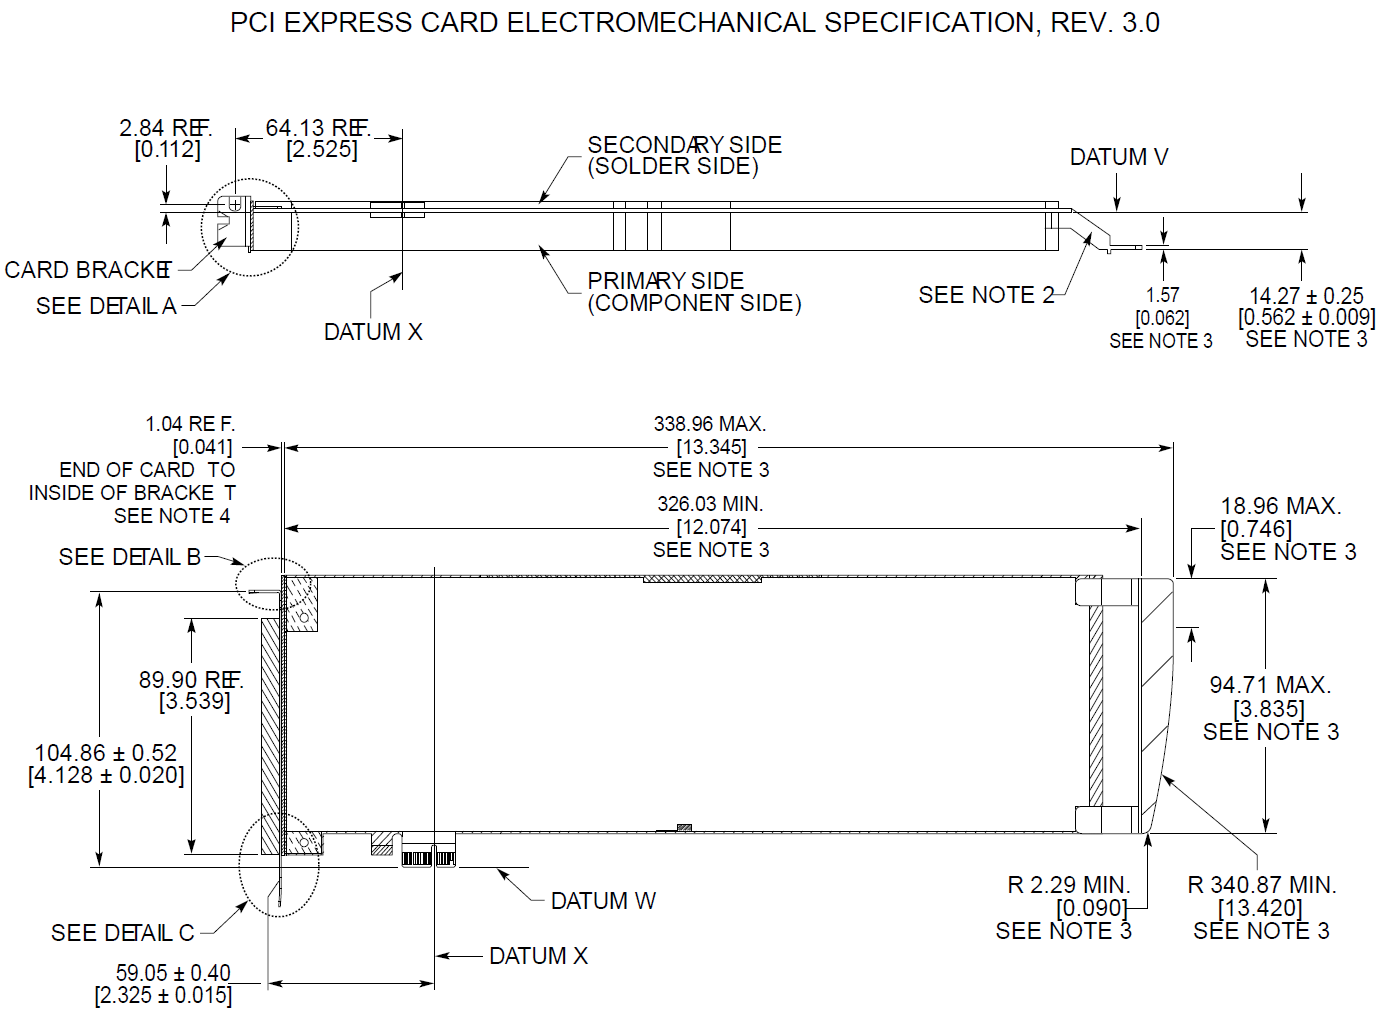
hw/mech/pcie-card-bracket-dimensions.PNG
