rack-ten-compute/10-inch-homelab-computer/hw/mech/pcie-card-dimensions.png

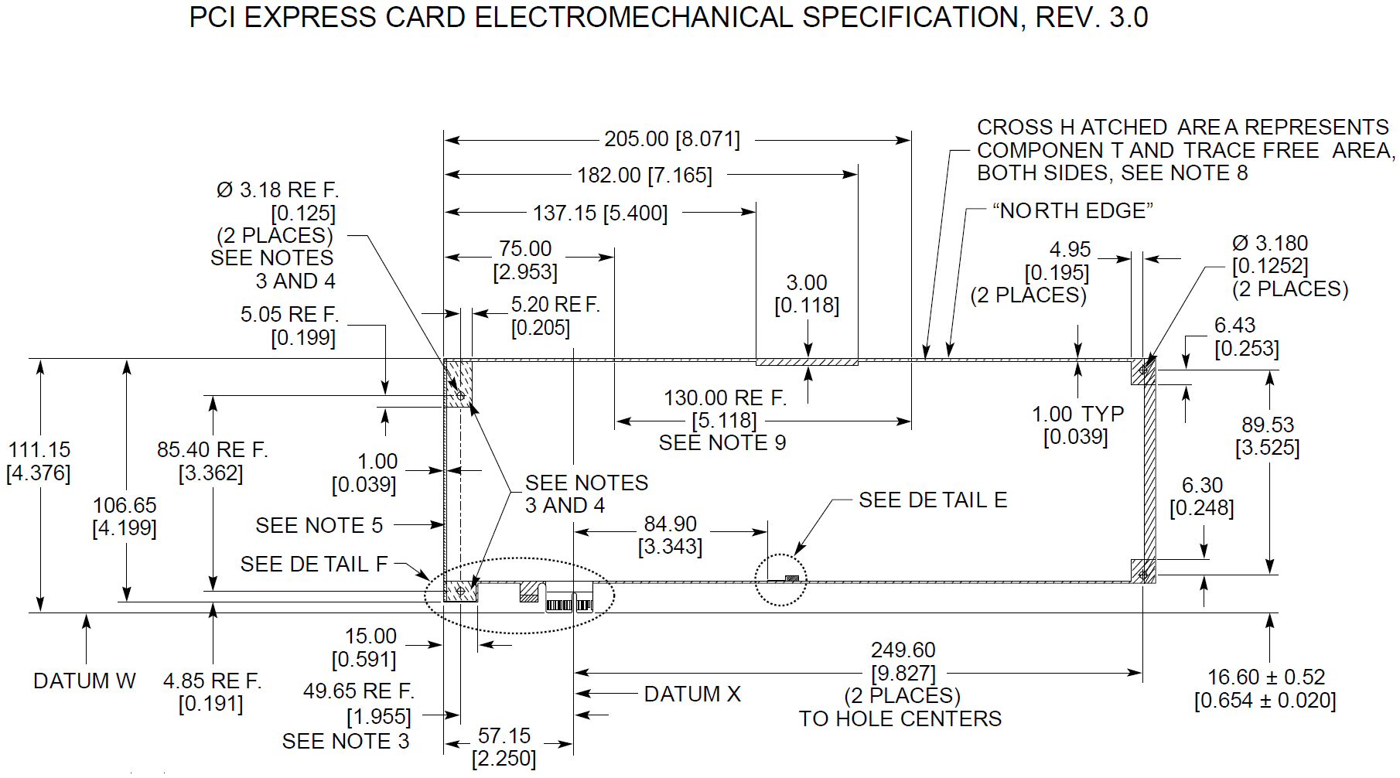
hw/mech/pcie-card-dimensions.png
