rack-ten-compute/10-inch-homelab-computer/hw/bom/README.md

# Компоненты для несущей платы

| № | Название папки | Компоненты |
|:-:|:---|:---|
| 1 | [connectors/comexpress](connectors/comexpress) |<ul><li>[3-1827253-6 (разъём COM Express Type 6, Molex)](connectors/comexpress/3-1827253-6.pdf)</li><li>[QT002206-2131-3H (эквивалент Foxconn 5H, LCSC C2761498)](connectors/comexpress/QT002206-2131-3H.pdf)</li><li>[QT002206-4131-3H (эквивалент Foxconn 8H, LCSC C2761499)](connectors/comexpress/QT002206-4131-3H.pdf)</li></ul> |
| 2 | [connectors/pcie/x8](connectors/pcie/x8) |<ul><li>[3091-10102T (разъём PCIe x8, UMAX, LCSC C444346, в наличии 384 шт.)](connectors/pcie/x8/3091-10102T-C444346.pdf)</li><li>[2EG14917-D2D8-4F (разъём PCIe x8, Foxconn, LCSC C426231)](connectors/pcie/x8/2EG14917-D2D8-4F-C426231.pdf)</li><li>[X3091WR-98B-9TV15 (разъём PCIe x8, XKB Connection, LCSC C30167382)](connectors/pcie/x8/X3091WR-98B-9TV15-C30167382.pdf)</li><li>[3157-00102D (разъём PCIe x8, Molex, LCSC C425881)](connectors/pcie/x8/3157-00102D-C425881.pdf)</li><li>[PCIE-098-02-F-D-EMS2-BG (разъём PCIe x8, Samtec, LCSC C4810552)](connectors/pcie/x8/PCIE-098-02-F-D-EMS2-BG-C4810552.pdf)</li></ul> |
| 3 | [connectors/pcie/x16](connectors/pcie/x16) |<ul><li>[X3091WR-164B-9TV15 (разъём PCIe x16, XKB Connection, LCSC C30167380)](connectors/pcie/x16/X3091WR-164B-9TV15-C30167380.pdf)</li><li>[WPRS-164AL1B7U (разъём PCIe x16, staggered pins, LCSC C54930168)](connectors/pcie/x16/WPRS-164AL1B7U-C54930168.pdf)</li></ul> |
| 4 | [connectors/power](connectors/power) | [B4PS-VH (разъём JST VH 6-pin 3.96mm, LCSC C157996 / C566023)](connectors/power/B4PS-VH(LF)(SN)-C157996_B4PS-VH-B(LF)(SN)-C566023.pdf) |
| 5 | [connectors/sata](connectors/sata) |<ul><li>[0470804001 (разъём SATA signal, 7-pin 1.27mm, Molex)](connectors/sata/0470804001.PDF)</li><li>[SATA-401-M07S1BY-A (разъём SATA, LCSC C7500835)](connectors/sata/SATA-401-M07S1BY-A-C7500835.pdf)</li></ul> |
