rack-ten-compute/10-inch-homelab-computer/hw/bom/connectors/comexpress/3-1827253-6.JPG

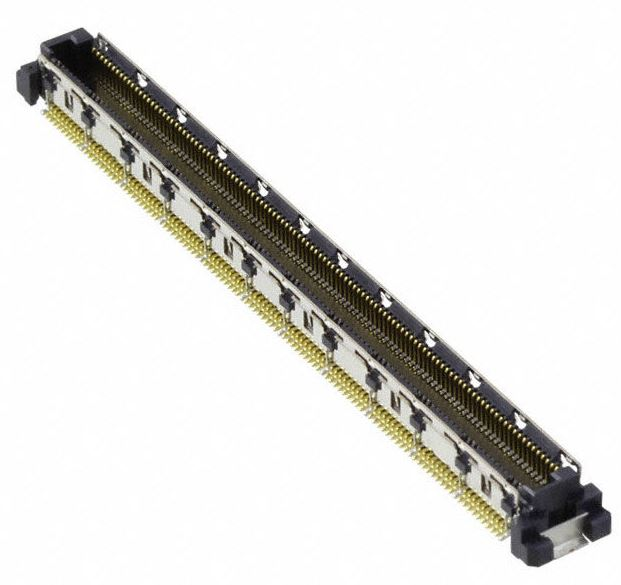
hw/bom/connectors/comexpress/3-1827253-6.JPG
