rack-ten-compute/10-inch-homelab-computer/hw/bom/connectors/power/2x-sata-15p-vh.PNG

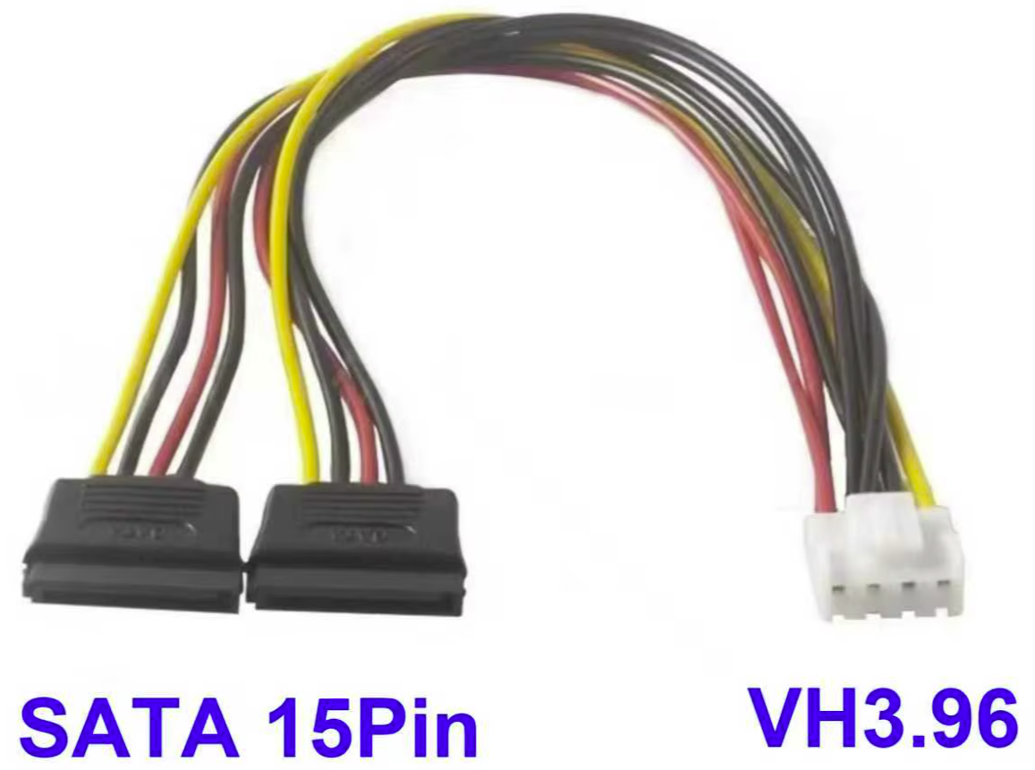
hw/bom/connectors/power/2x-sata-15p-vh.PNG
