rack-ten-compute/10-inch-homelab-computer/(list of files, cad)

Other CAD files:
docs/SOM-5871/3d/SOM-5871_STEP/SOM-5871.STEP
