rack-ten-compute/10-inch-homelab-computer/hw/ddi-hdmi-guide.md

# SOM-5871 — Подключение HDMI к DDIx

Описание реализации **HDMI** на несущей плате от DDI-канала модуля
(`DDIX`, X = 1–3). Выводы DDI на разъёме — см. [pinout.md](pinout.md),
сводка по группам.

Источники (раздел **2.5 Digital Display Interfaces (DDI)** из
[`docs/SOM-5871/design/SOM-5871 COM Express Type 6 Design Guide Rev110_220708.pdf`](../docs/SOM-5871/design/SOM-5871%20COM%20Express%20Type%206%20Design%20Guide%20Rev110_220708.pdf)):

- **2.5.1 DDI Signal Definitions** — пин-аут DDI (Table 13) и описания сигналов;
- **2.5.2.2 HDMI / DVI Routing Guidelines** — разводка TMDS для HDMI;
- **2.5.3 HDMI / DVI Level Shifter Requirements** — требования к level shifter;
- **2.5.4 ESD Protection** — защита от ESD.

> Примечание: проверьте в спецификации модуля, что поддерживается
> **Dual-Mode DisplayPort** (а не только DP) — именно он позволяет напрямую
> выдавать HDMI-сигналы (Table 13, Note).

## 1. Отображение сигналов DDI → HDMI (Design Guide, §2.5.1, Table 13)

Каждый DDI-канал: 4 дифференциальные TMDS-пары, 1 AUX-пара и 1 HPD.
На HDMI AUX-пара переиспользуется как канал DDC (I2C):

| Сигнал DDI | Пин DDI1 | Пин DDI2 | Пин DDI3 | Функция на HDMI (DDIX) |
|:---|:---:|:---:|:---:|:---|
| `DDIX_PAIR0+` | D26 | D39 | C39 | `TMDSX_DATA2+` |
| `DDIX_PAIR0-` | D27 | D40 | C40 | `TMDSX_DATA2-` |
| `DDIX_PAIR1+` | D29 | D42 | C42 | `TMDSX_DATA1+` |
| `DDIX_PAIR1-` | D30 | D43 | C43 | `TMDSX_DATA1-` |
| `DDIX_PAIR2+` | D32 | D46 | C46 | `TMDSX_DATA0+` |
| `DDIX_PAIR2-` | D33 | C47 | C47 | `TMDSX_DATA0-` |
| `DDIX_PAIR3+` | D36 | D49 | C49 | `TMDSX_CLK+` |
| `DDIX_PAIR3-` | D37 | D50 | C50 | `TMDSX_CLK-` |
| `DDIX_HPD` | C24 | D44 | C44 | `HDMIX_HPD` |
| `DDIX_CTRLCLK_AUX+`  | D15 | C32 | C36 | `HDMIX_CTRLCLK` |
| `DDIX_CTRLCLK_AUX-`  | D16 | C33 | C37 | `HDMIX_CTRLDATA` |
| `DDIX_DDC_AUX_SEL` | D34 | C34 | C38 | — (управляющий) |

> Подробные описания каждого сигнала (I/O, уровни, что уже интегрировано на
> модуле, что ставить на несущей плате) — **Table 14** (DDI1) из Design Guide
> §2.5.1; для DDI2/DDI3 — аналогичные Table 15/16.

**Ключевые точки:**

- `DDIX_DDC_AUX_SEL` **подтянуть к 3,3 В резистором 100 кОм** на несущей плате,
  чтобы AUX-пара (`CTRLCLK/CTRLDATA`) работала как канал DDC. На модуле уже есть
  подтяжка к GND (PD), поэтому достаточно PU на стороне COMe.
- `DDIX_HPD` — вход (3,3 В, open drain): модуль содержит
  current-blocking-контур и PD-резистор к GND. На несущей плате — **3,3→5 В
  level shifter** на вывод HPD HDMI-разъёма (см. §2.5.1, Table 14, DDI1_HPD).
- `DDIX_CTRLCLK_AUX+` / `DDIX_CTRLCLK_AUX-` (DDC, 3,3 В, OD) — **двунаправленный
  3,3↔5 В level shifter** + подтяжки 2 кОм (см. ниже).
- `DDIX_PAIR[0:3]` — TMDS (PCIE-уровень, O): AC-связь + level shifter (см. ниже).
- Если канал не используется — N/C.

## 2. Разводка HDMI (Design Guide, §2.5.2.2)

Требования к несущей плате (TMDS / HDMI):

- **Level shifter** на TMDS-сигналах `DDIX_PAIR[0:3]` (обязателен: HDMI-приёмник
  терминируется 50 Ом к ~3,3 В (AVCC), нативные сигналы DDI должны быть
  сдвинуты по уровню — §2.5.3).
- **Двунаправленный level shifter 3,3↔5 В** на `DDIX_CTRLCLK_AUX+` и
  `DDIX_CTRLCLK_AUX-` (DDC-канал 3,3 В модуля → 5 В HDMI).
- **Подтяжки 2 кОм** на `CTRLCLK`/`CTRLDATA` **с обеих сторон** level shifter:
  к 3,3 В (сторона модуля) и к 5 В (сторона HDMI-дисплея).
- `DDIX_DDC_AUX_SEL` — **PU 100 кОм к 3,3 В** (конфигурирует AUX как DDC).
- **AC-блокировочные конденсаторы** (75–200 нФ) на `DDIX_PAIR[0:3]`.
- **Blocking FET** на `DDIX_HPD` — защита модуля от обратного тока.

### 2.1 Требования к трассировке (Design Guide, §2.5.2.2, Table 20)

| Параметр | Требование |
|:---|:---|
| Дифференциальное сопротивление | 85 Ом ±5 % |
| Однополярное сопротивление | 50 Ом ±5 % |
| Изоляция до эквивалентных пар | 20 mils (MS) / 15 mils (DS) |
| Изоляция до других групп сигналов | 20 mils (MS) / 15 mils (DS) |
| Расстояние между трассами (spacing) | 20 mils (MS) / 15 mils (DS) |
| Макс. длина LA+LB (DDI → HDMI/DVI разъём) | **6 дюймов** |
| Length matching (внутри пары, intra-pair) | ≤ ±5 mils |
| Length matching (между парами, inter-pair) | ≤ 1,8 дюйма, **включая DDC-сигнал** |
| Опорная плоскость | GND, min 15-mil от края трассы до края плоскости |
| Сквозные переходы на несущей плате | max 2 |
| AC-связь | 75–200 нФ |

Примечания к Table 20:

1. AC-конденсаторы размещать ближе к стороне устройства (HDMI-разъём), не в
   середине трассы.
2. **HDMI 2.0 требует внешний retime/redriver** (retimer компенсирует random
   jitter, redriver усиливает сигнал).

## 3. ESD-защита (Design Guide, §2.5.4)

HDMI-порт подвержен ESD (подключение кабеля, контакт корпуса) — защита
обязательна. При 1,65 Гбит/с HDMI чувствителен к паразитной ёмкости, поэтому —
**TVS / ESD-диодные массивы с низкой ёмкостью**. Рекомендуемые параметры:

- выдерживают **≥ 8 кВ** ESD (по HDMI 1.4a требуется выдерживать 8 кВ);
- **ёмкость < 1 пФ** (минимизировать искажение при высоких скоростях);
- быстрое время отклика, малый ток утечки;
- не должны нарушать спецификацию HDMI по Voff (диод питания может
  открыться из-за 50-омной терминирующей нагрузки приёмника на 3,3 В) и
  целевое дифференциальное сопротивление HDMI.

Размещение: ESD-компоненты — как можно ближе к HDMI-разъёму, footprint **без
стубов и не более 750 mil (19,05 мм)** от разъёма.

## 4. Пример подключения HDMI к DDI

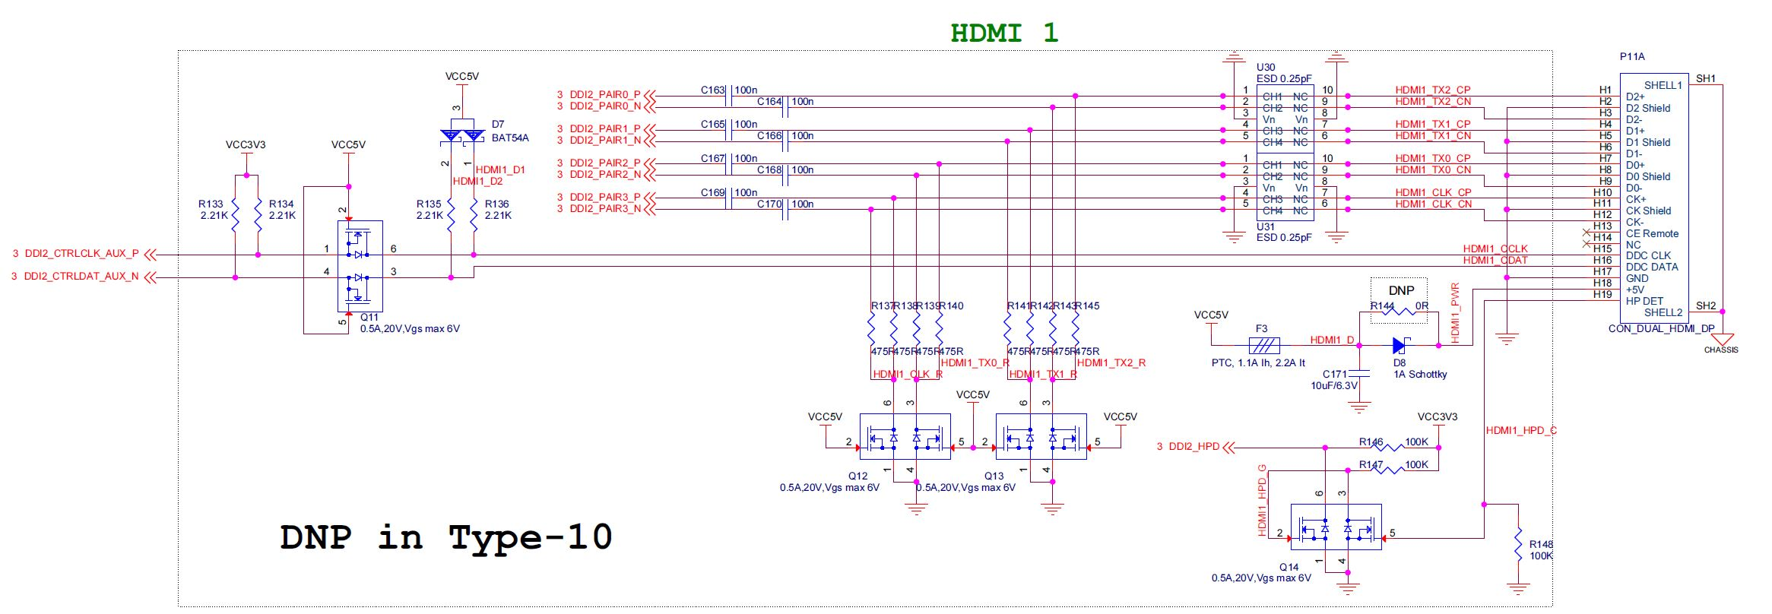
[picture p11: hw/hdmi/ddi-hdmi-sch.png]
Подключение HDMI к DDI из SB-COMEX


Пример из
[`docs/SOM-5871/competitor-boards/sb-comex_schematics_1V0.pdf`](../docs/SOM-5871/competitor-boards/sb-comex_schematics_1V0.pdf)
(стр. 11 — лист *HDMI 1 / HDMI 2 - DNP*).

На стр. 11 `AUX_SEL` для выбора HDMI устанавливается вручную в 1 через
логическую схему (вместо подтяжки 100 кОм, описанной в §1).
