rack-ten-compute/10-inch-homelab-computer/hw/bom/connectors/pcie/x8/X3091WR-98B-9TV15-C30167382.pdf

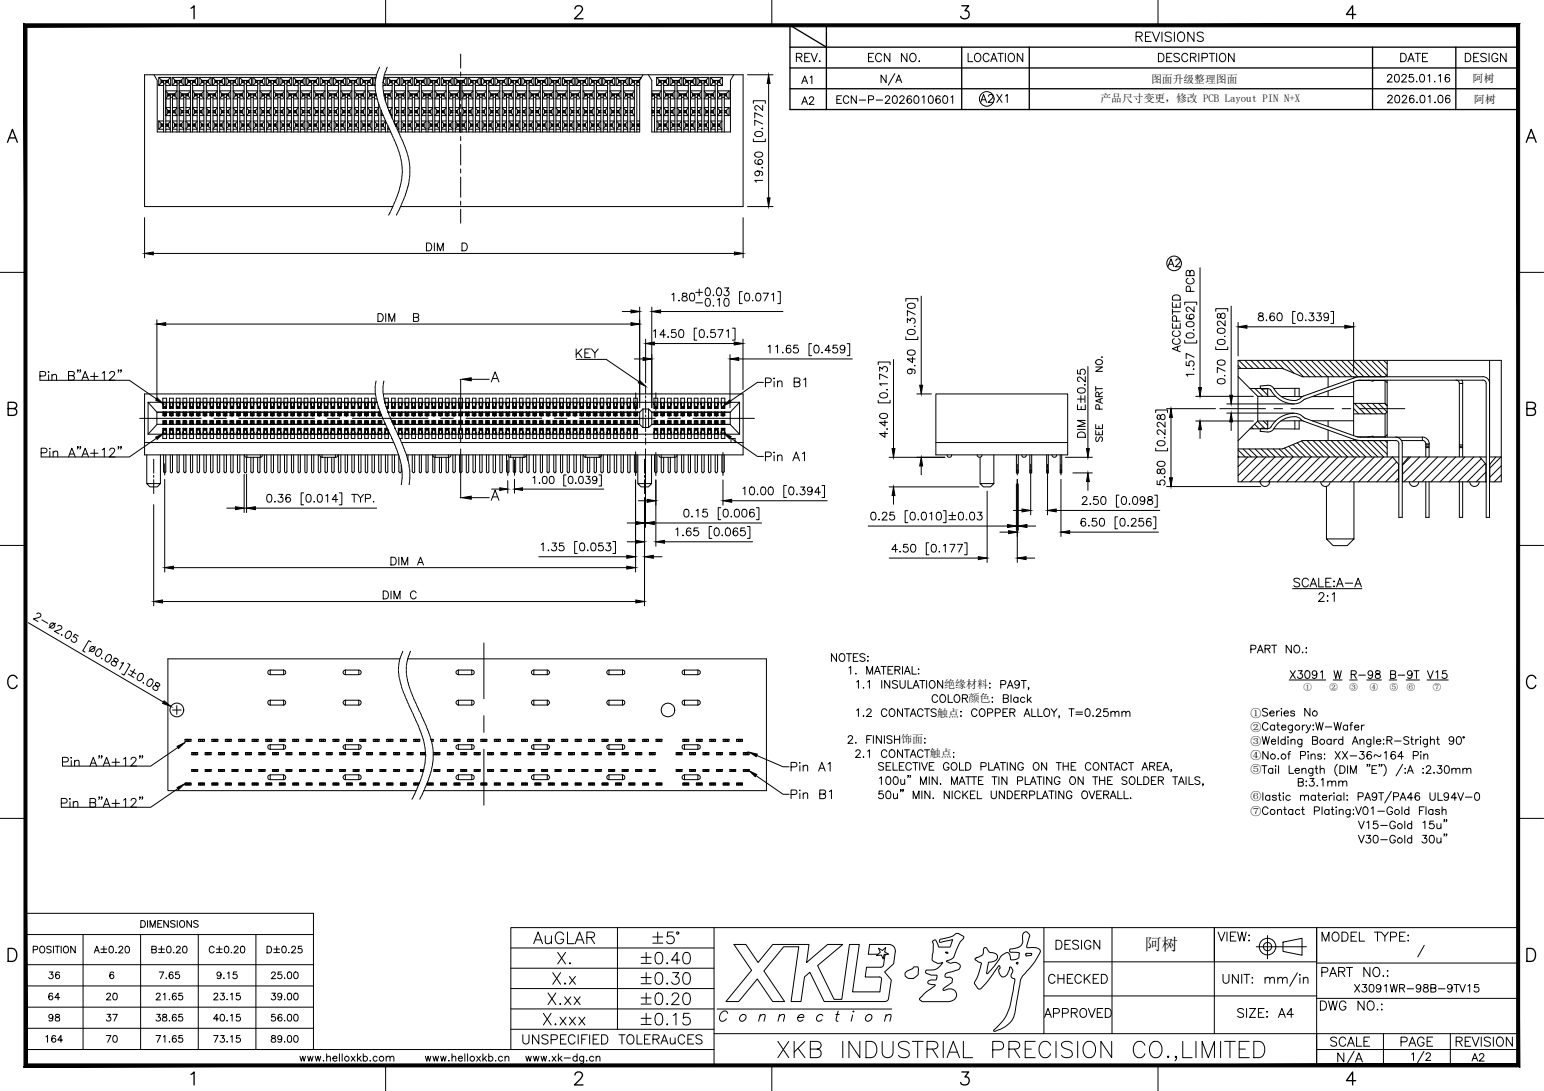
[picture p14: page 1]
产品尺寸变更，修改 PCB Layout PIN N+X; 图面升级整理图面; 绝缘材料 颜色

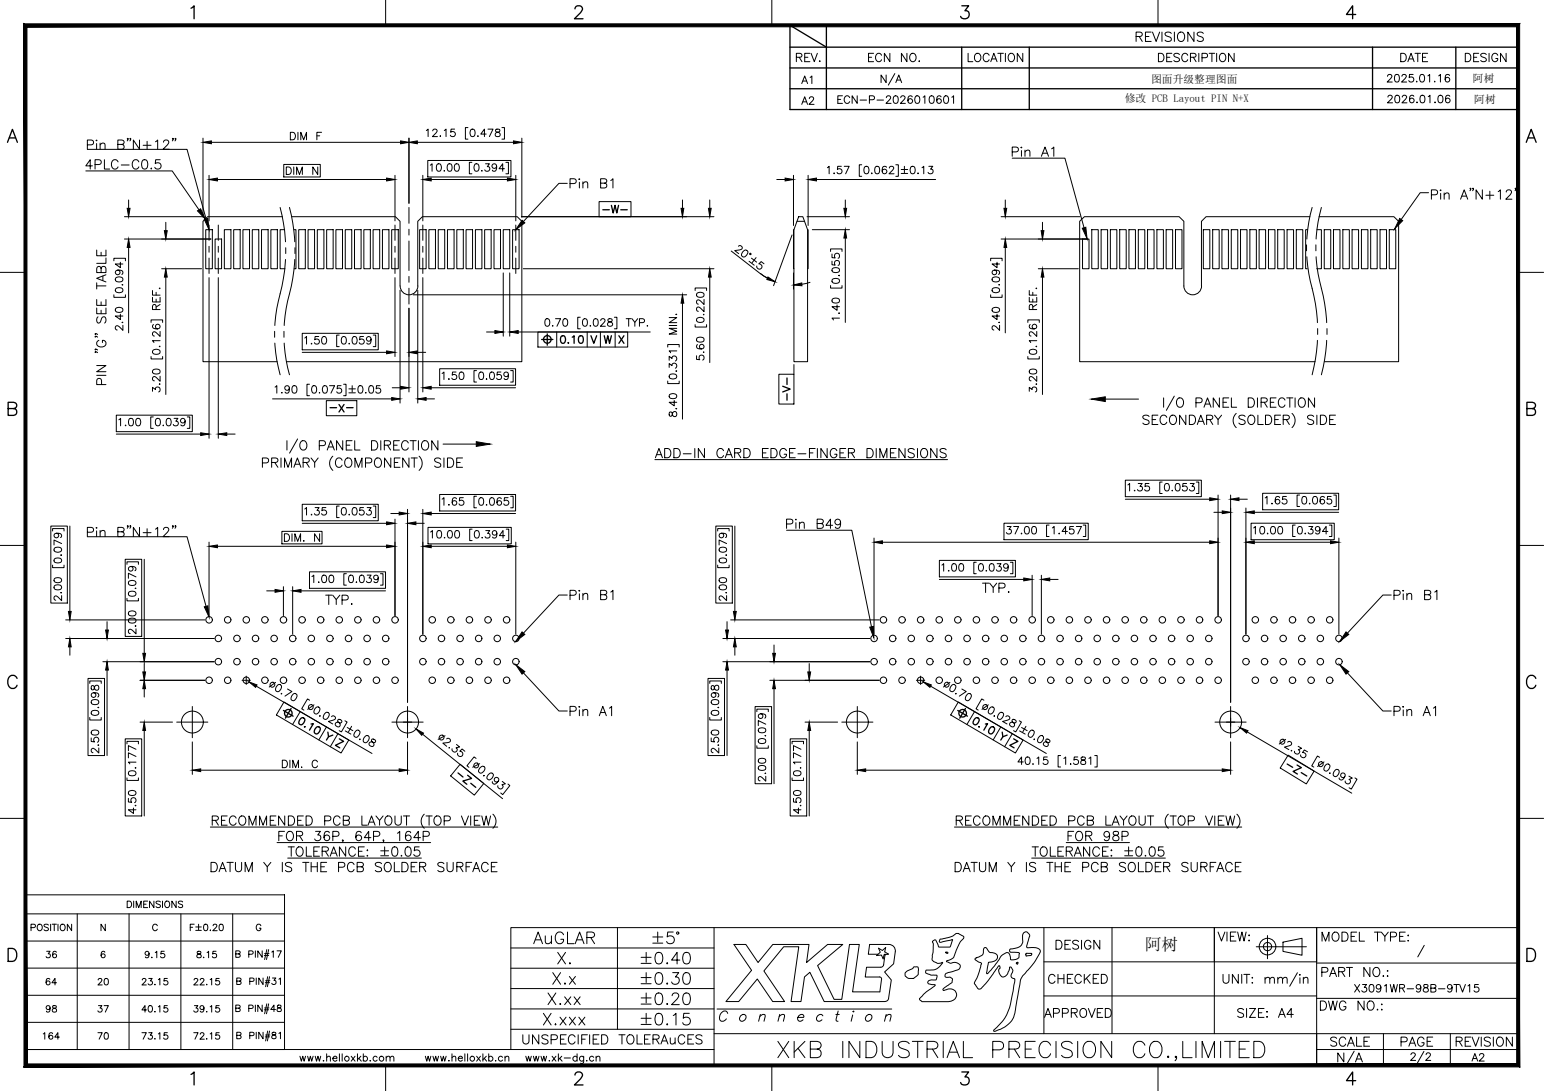
[picture p15: page 2]
修改 PCB Layout PIN N+X; 图面升级整理图面
