rack-ten-compute/10-inch-homelab-computer/hw/bom/connectors/sata/SATA-401-M07S1BY-A-C7500835.pdf

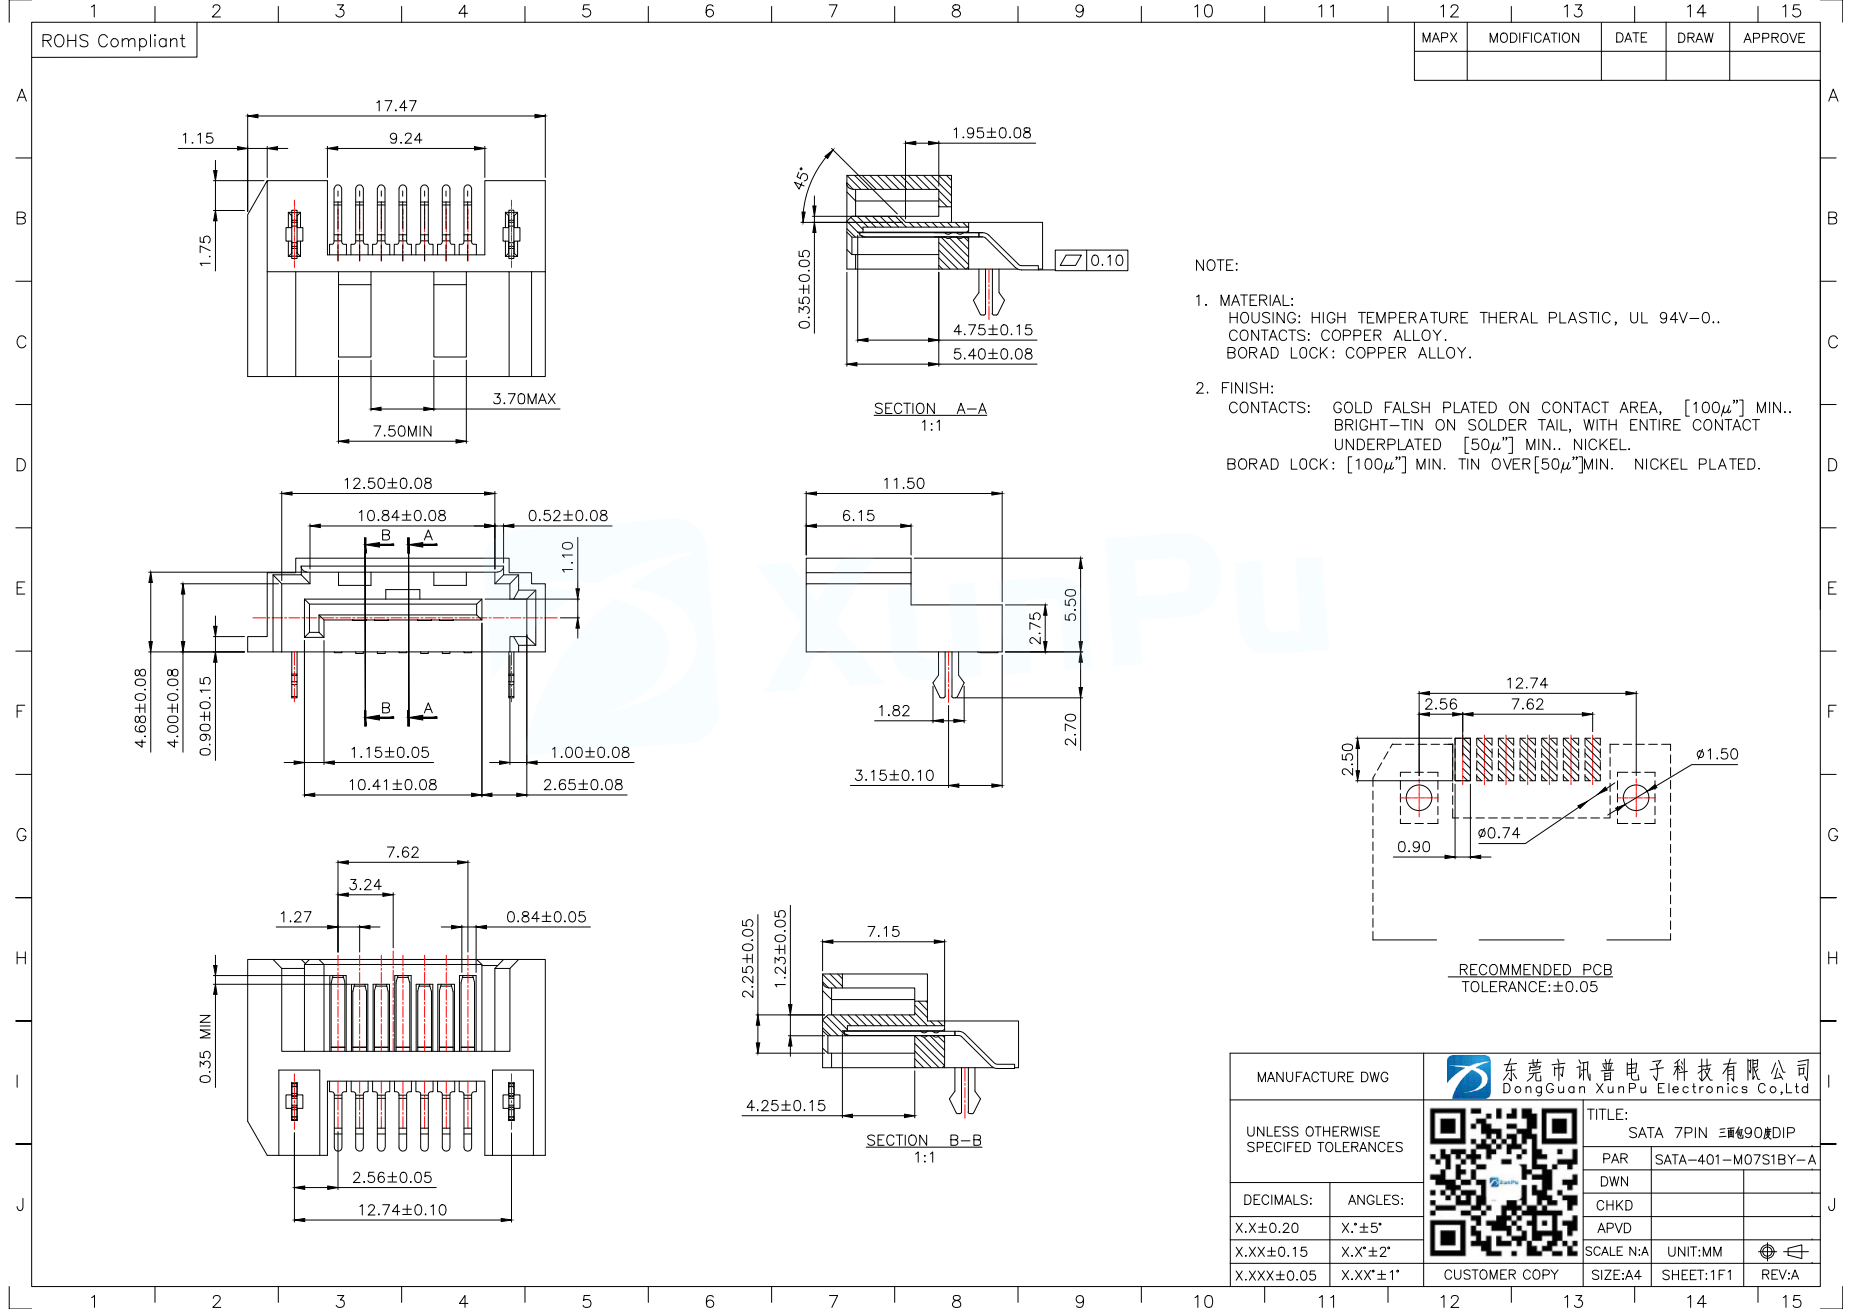
[picture p16: page 1]

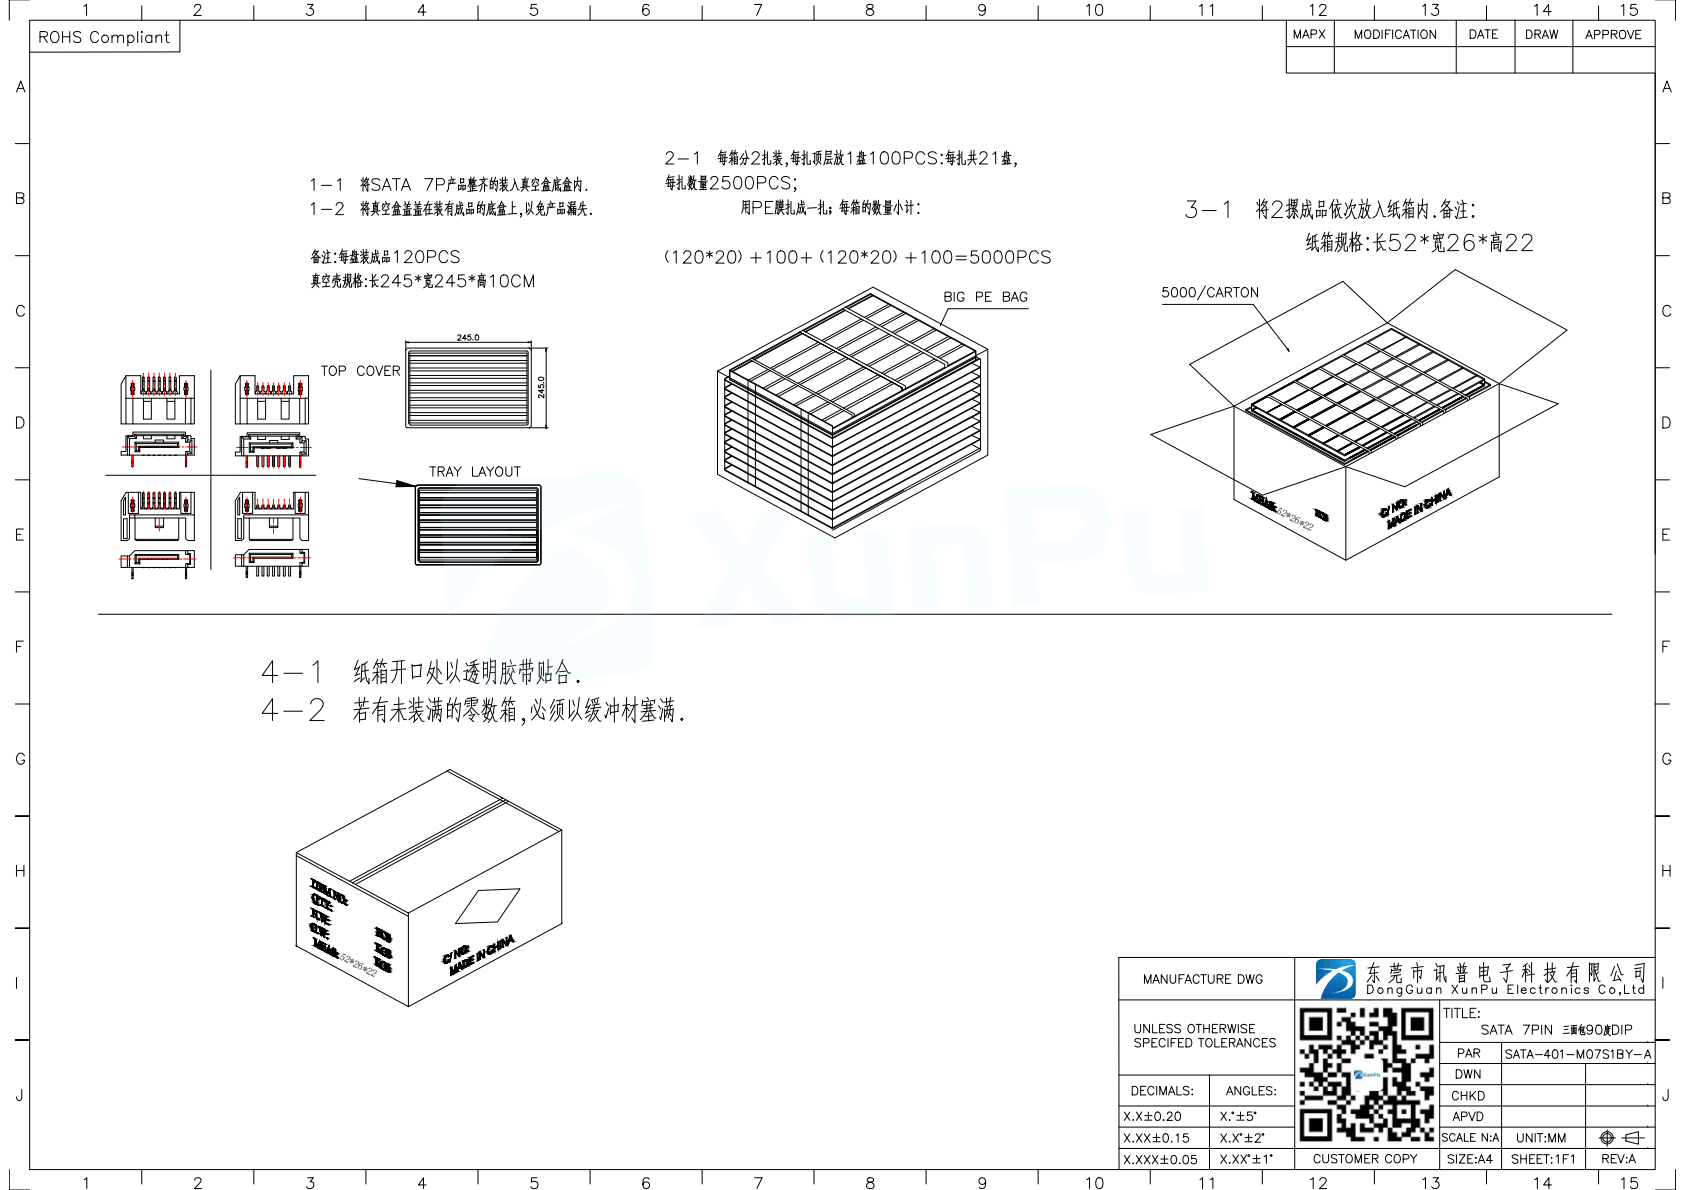
[picture p17: page 2]
