rack-ten-compute/10-inch-homelab-computer/hw/bom/connectors/comexpress/QT002206-2131-3H.pdf

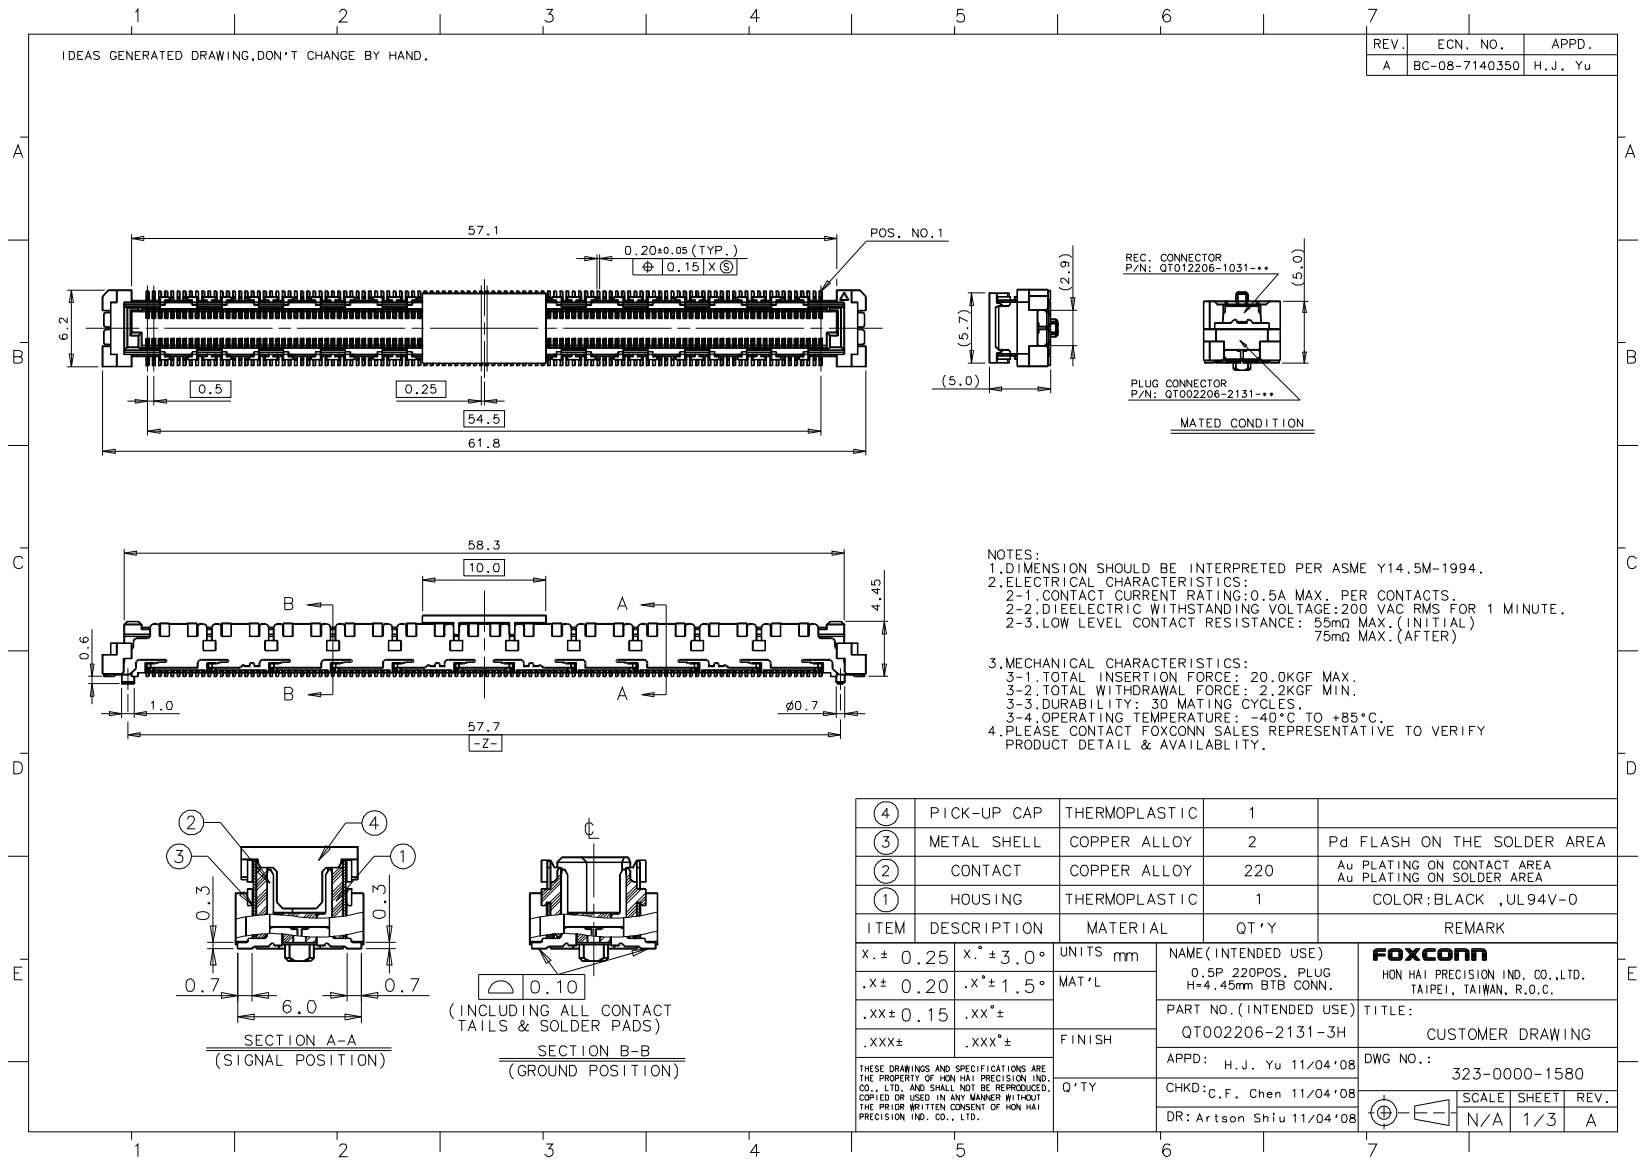
[picture p18: page 1]

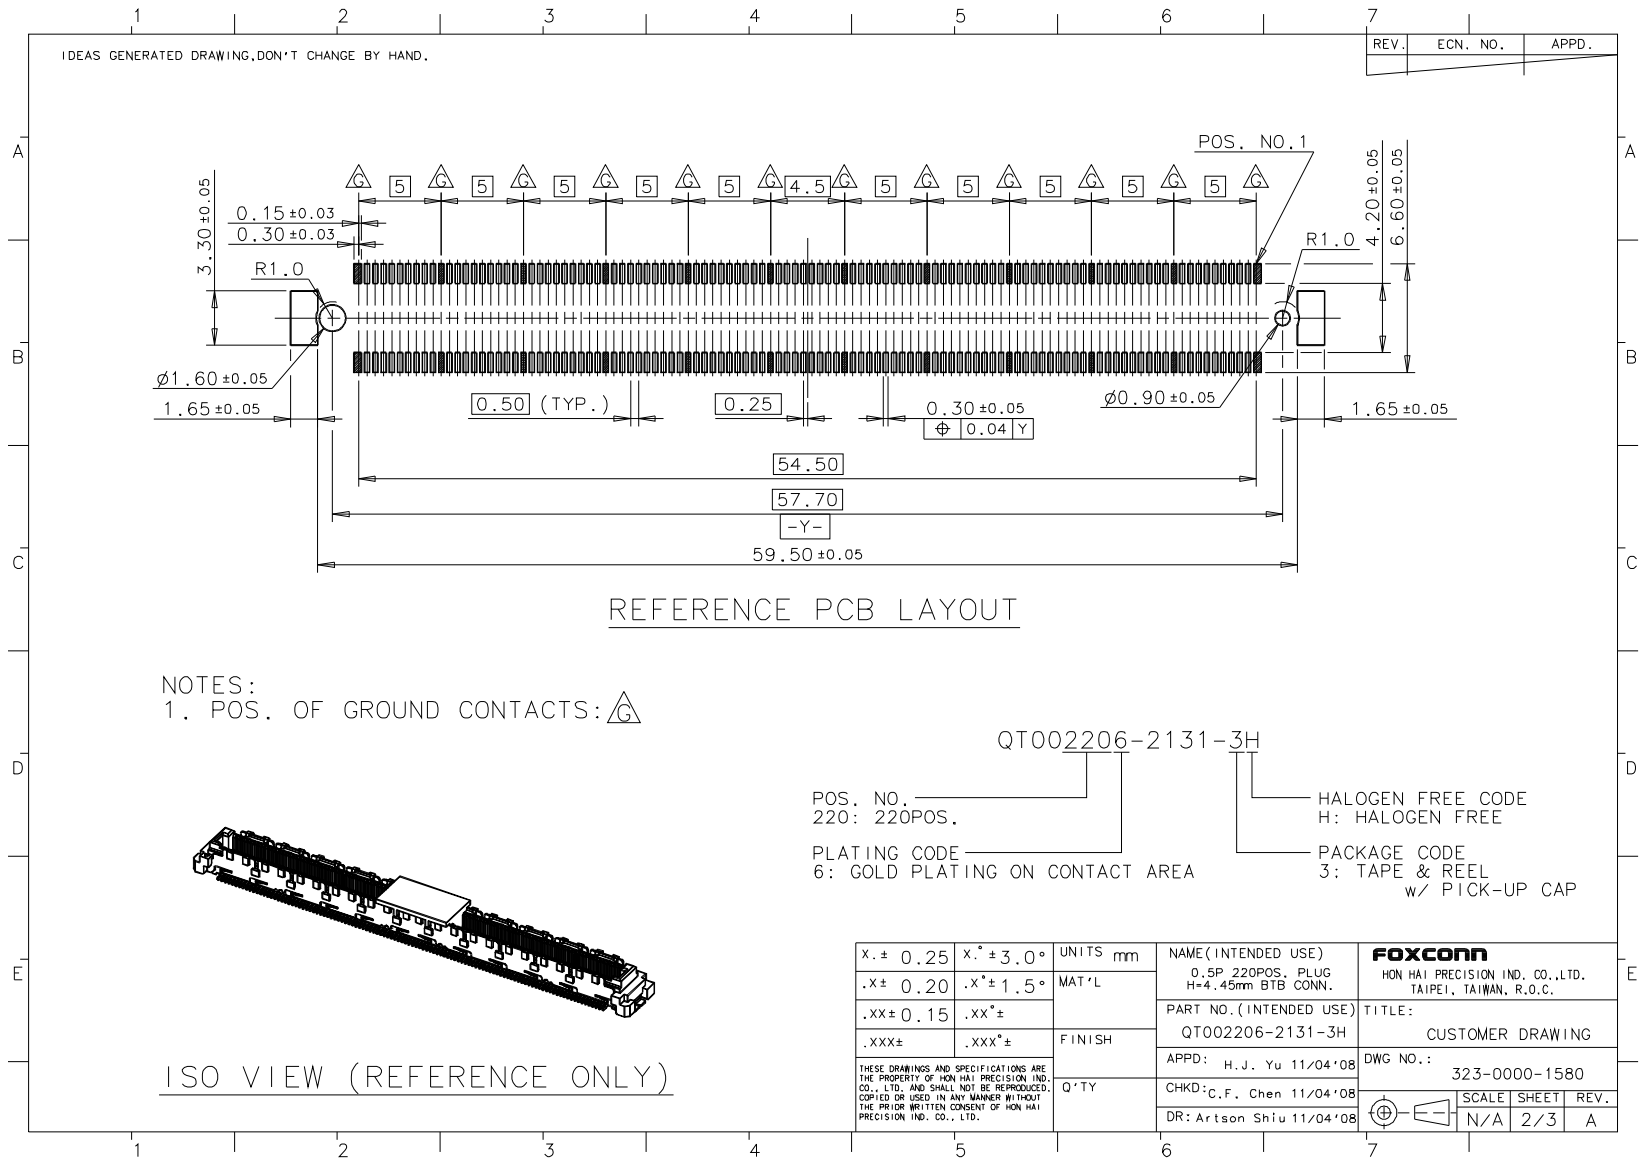
[picture p19: page 2]

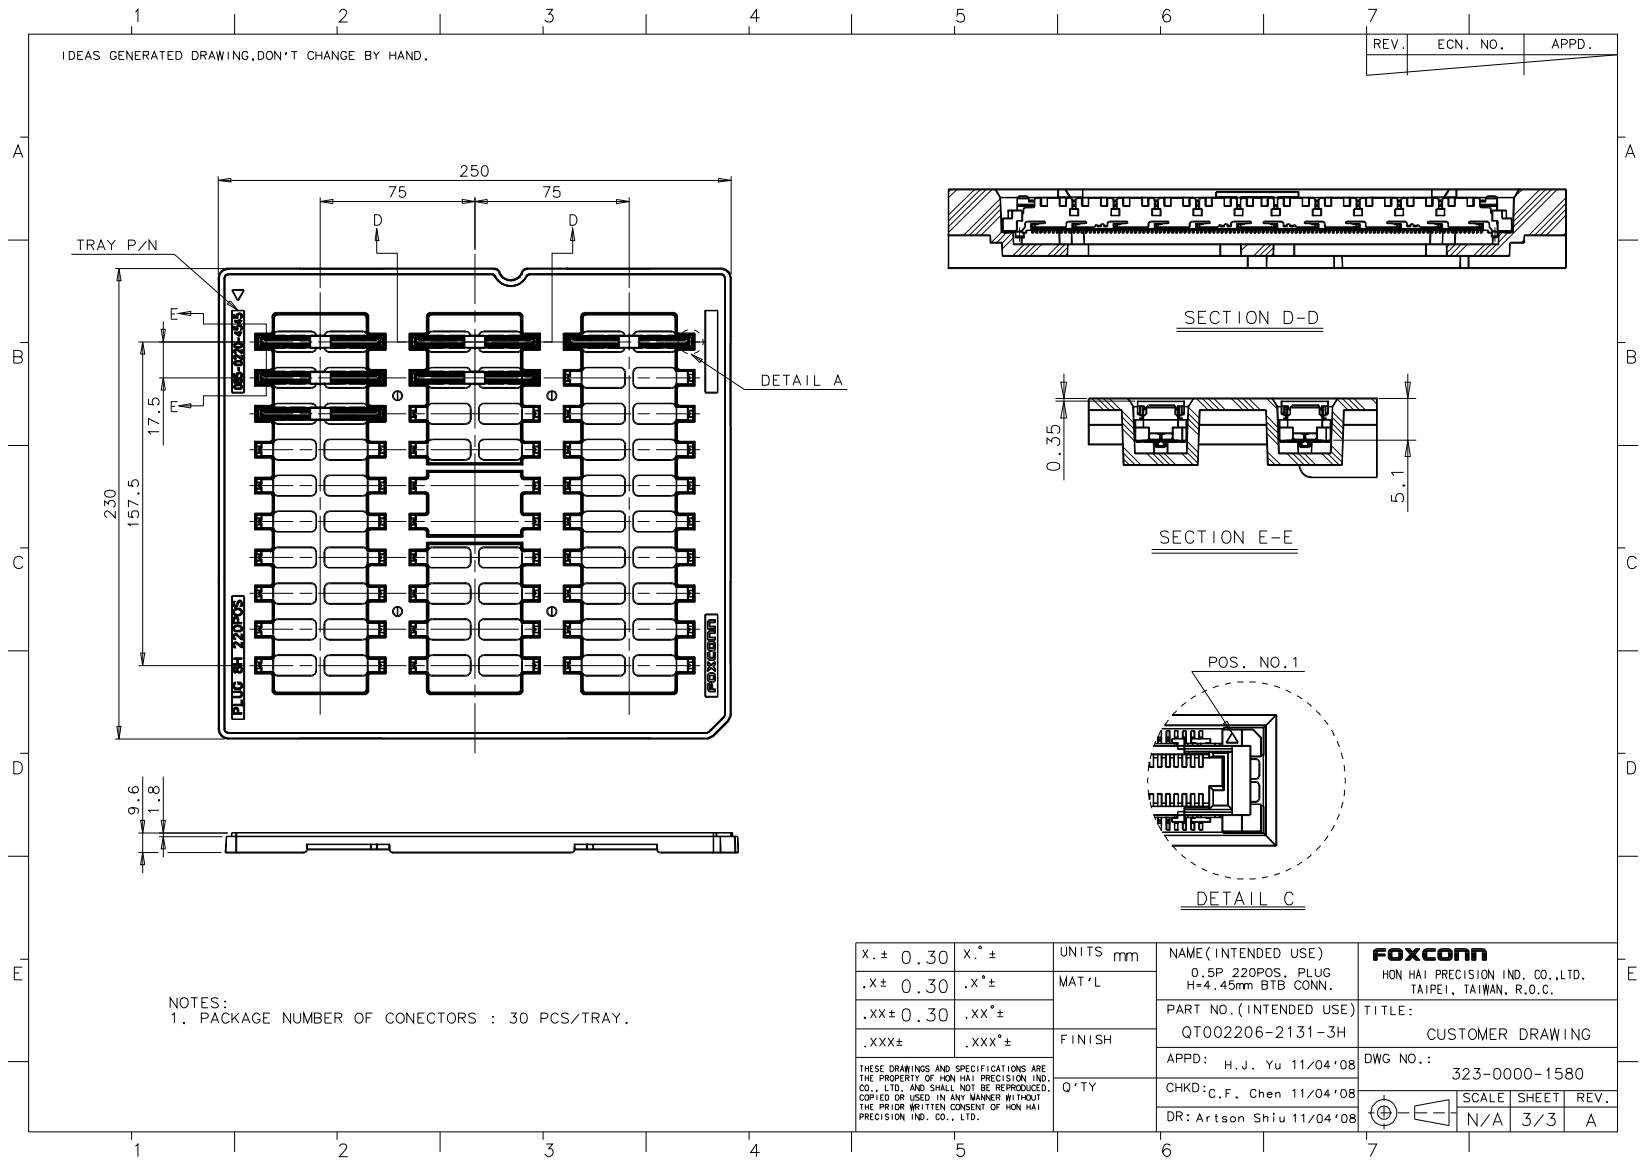
[picture p20: page 3]
