rack-ten-compute/10-inch-homelab-computer/hw/bom/connectors/comexpress/QT002206-4131-3H.pdf

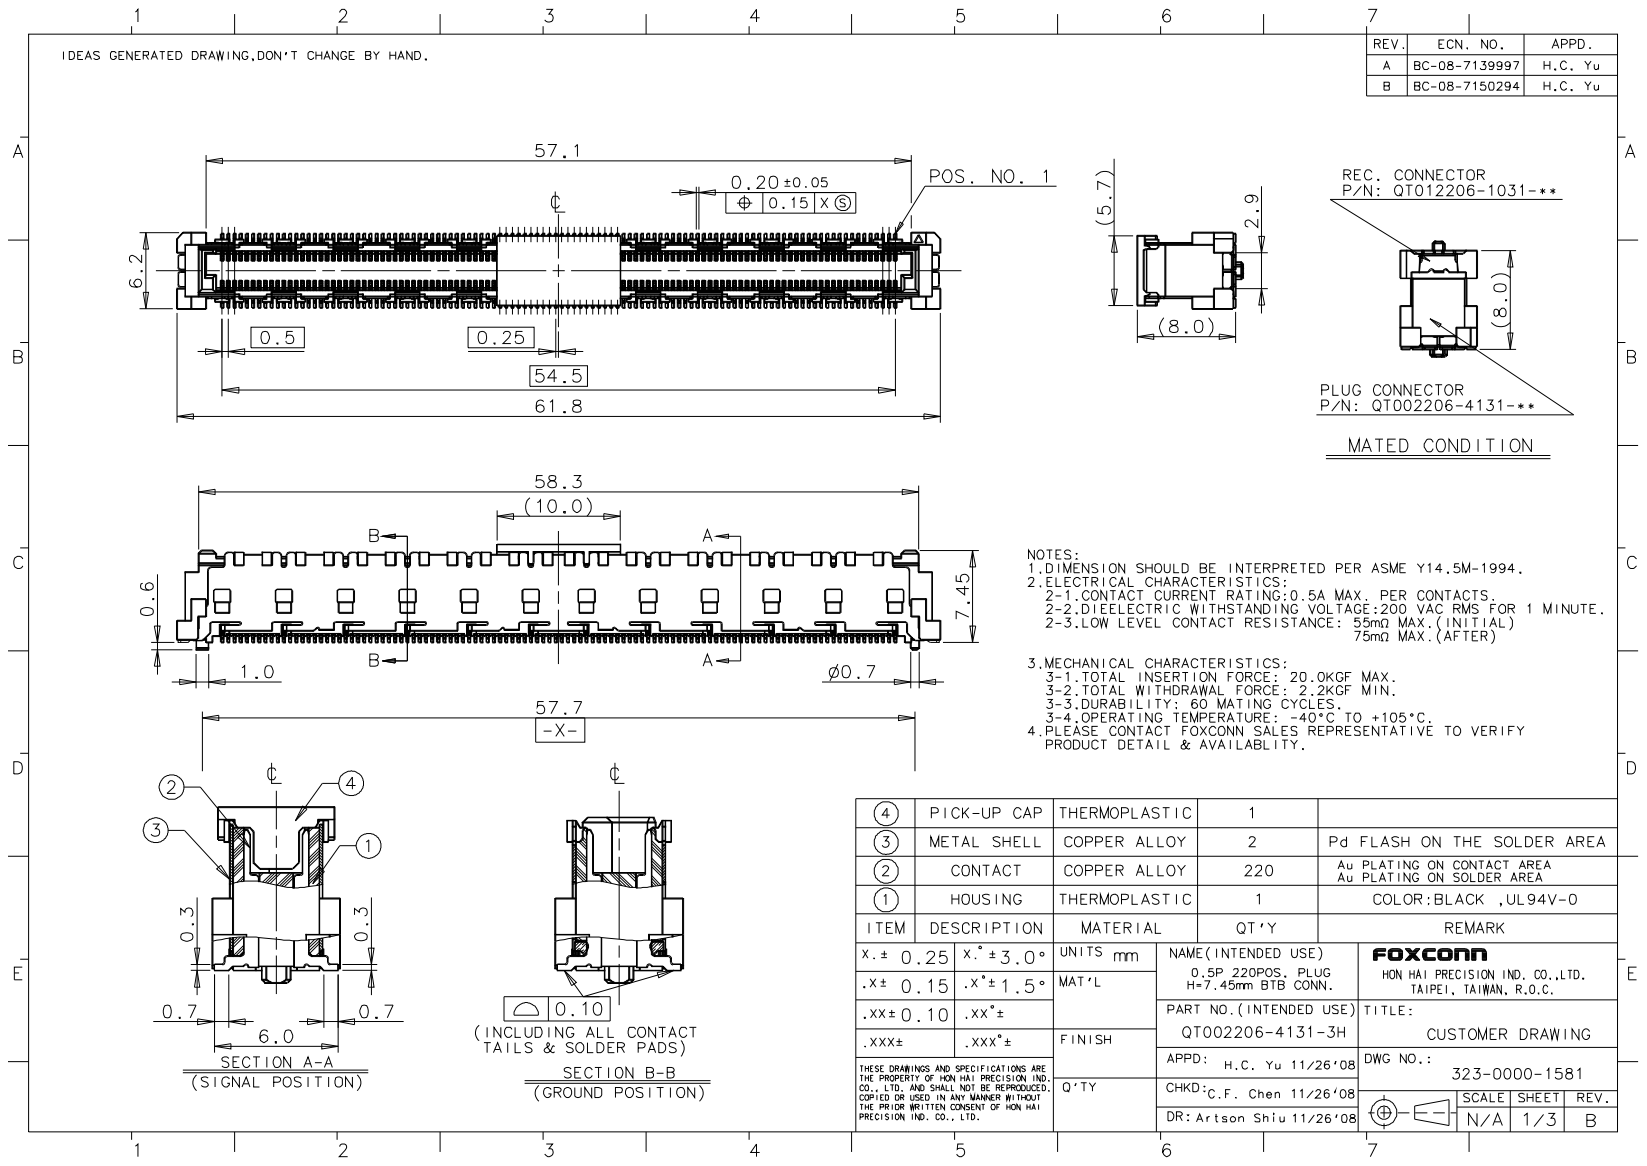
[picture p21: page 1]

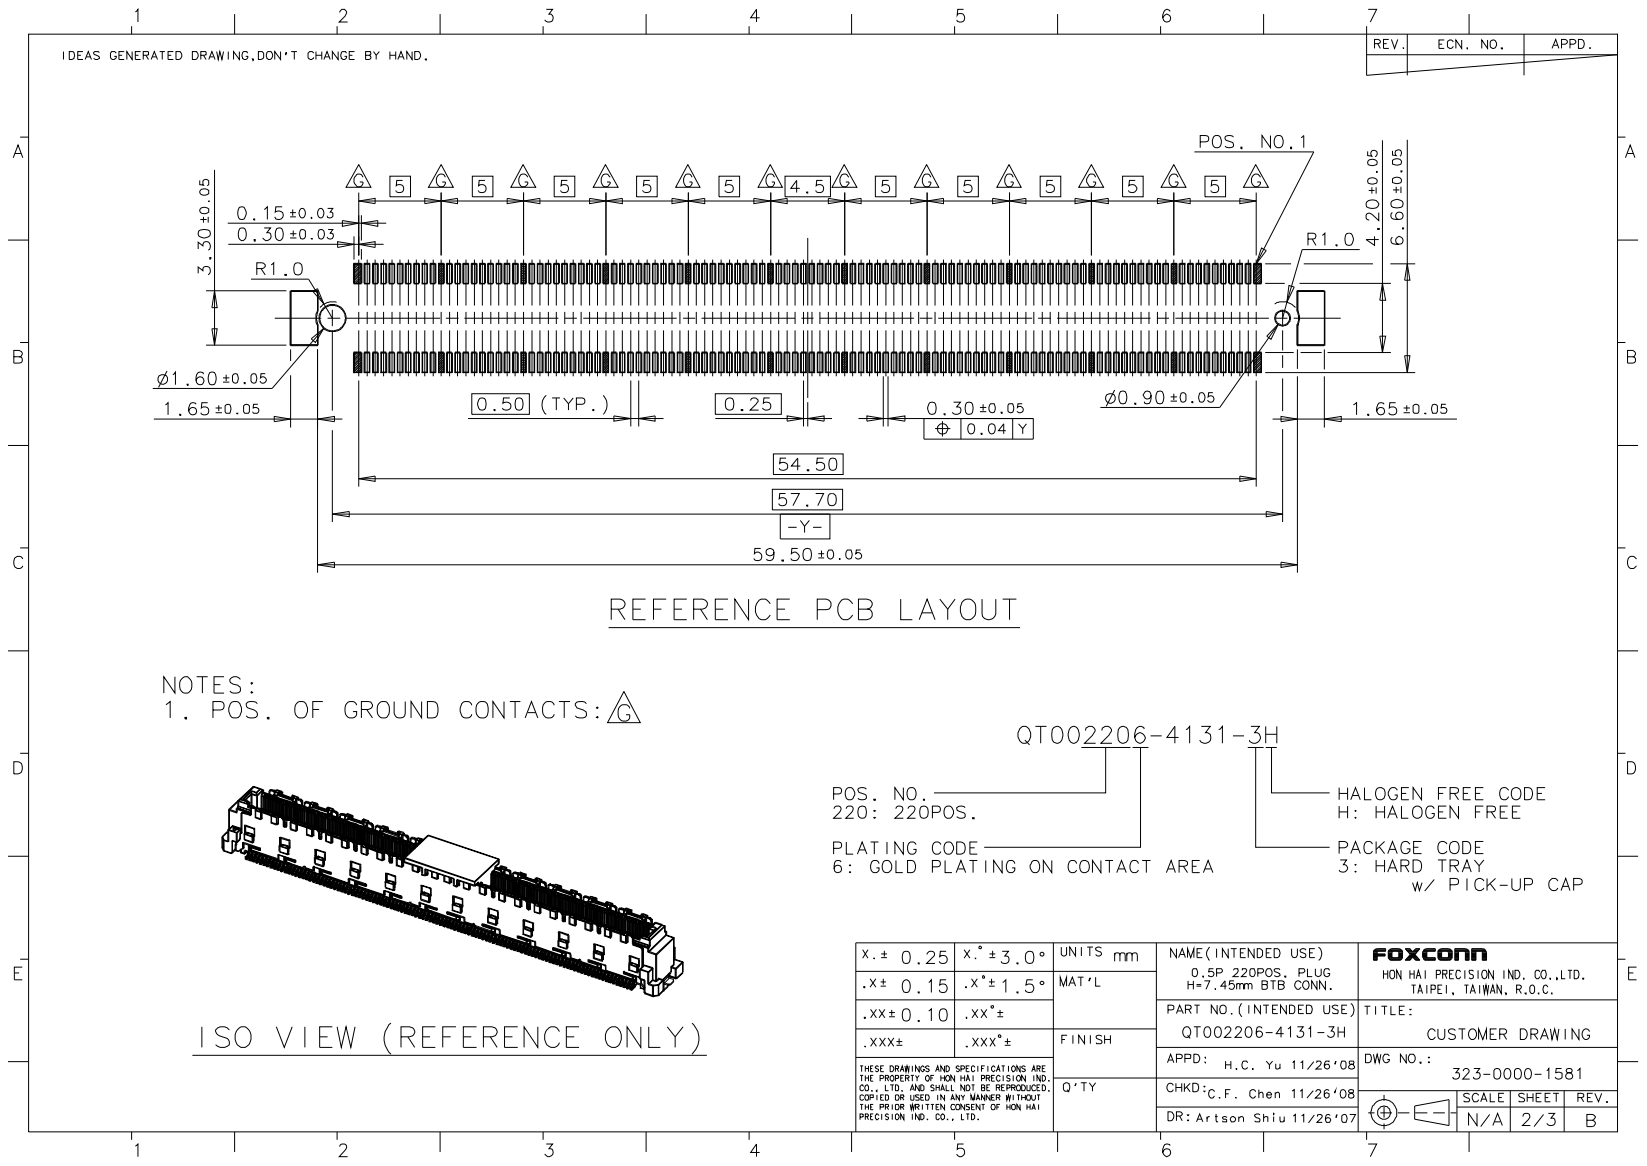
[picture p22: page 2]

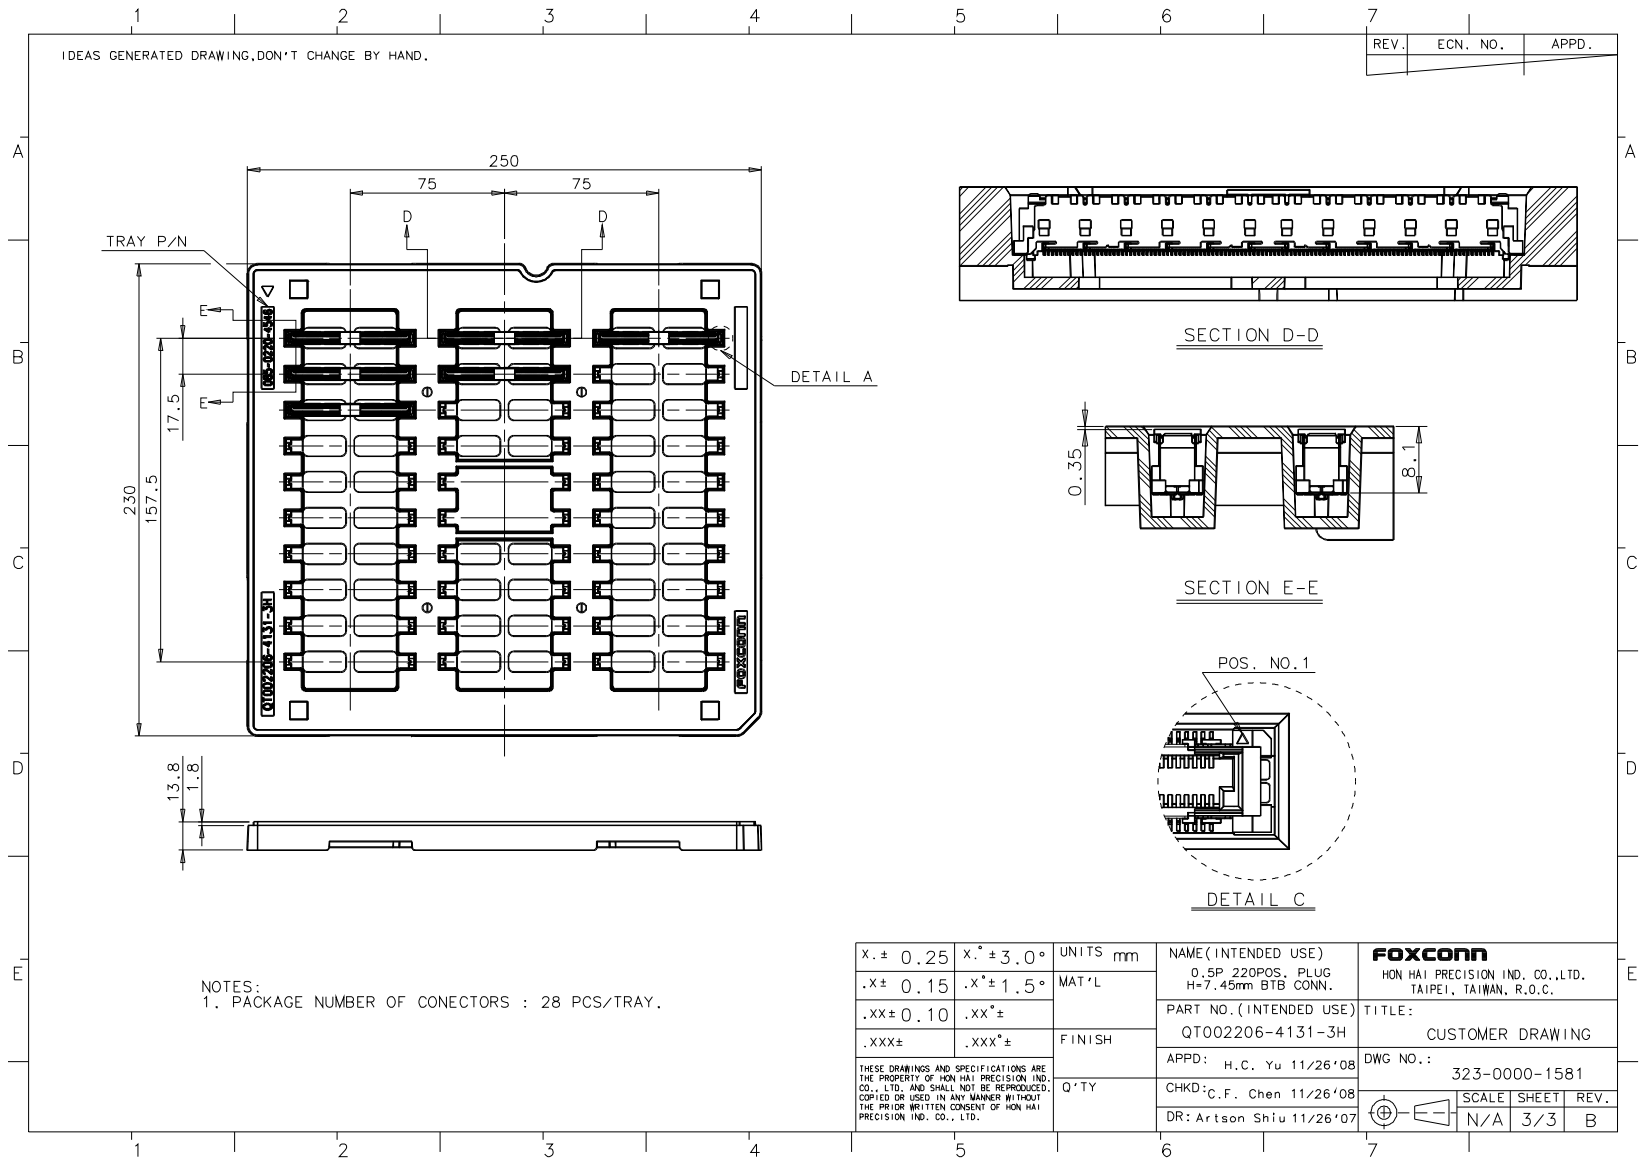
[picture p23: page 3]
