rack-ten-compute/10-inch-homelab-computer/hw/bom/connectors/comexpress/3-1827253-6.pdf

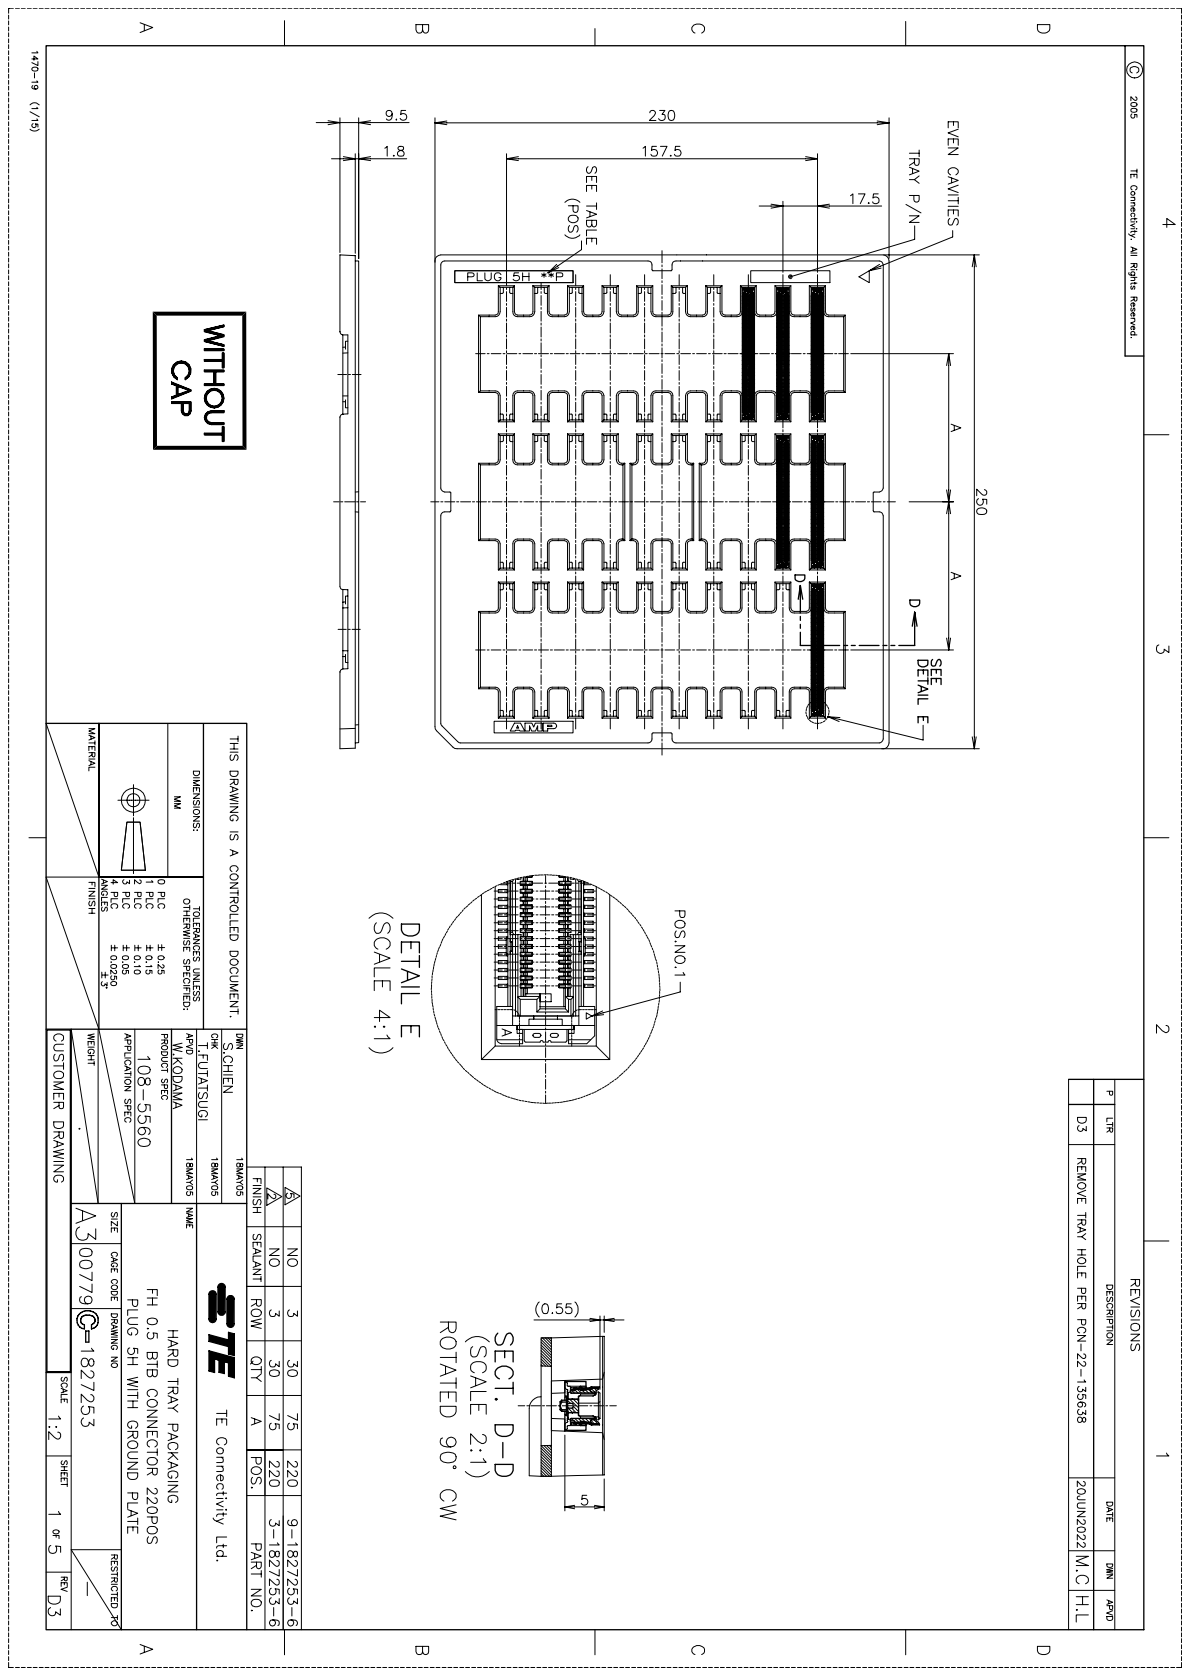
[picture p24: page 1]

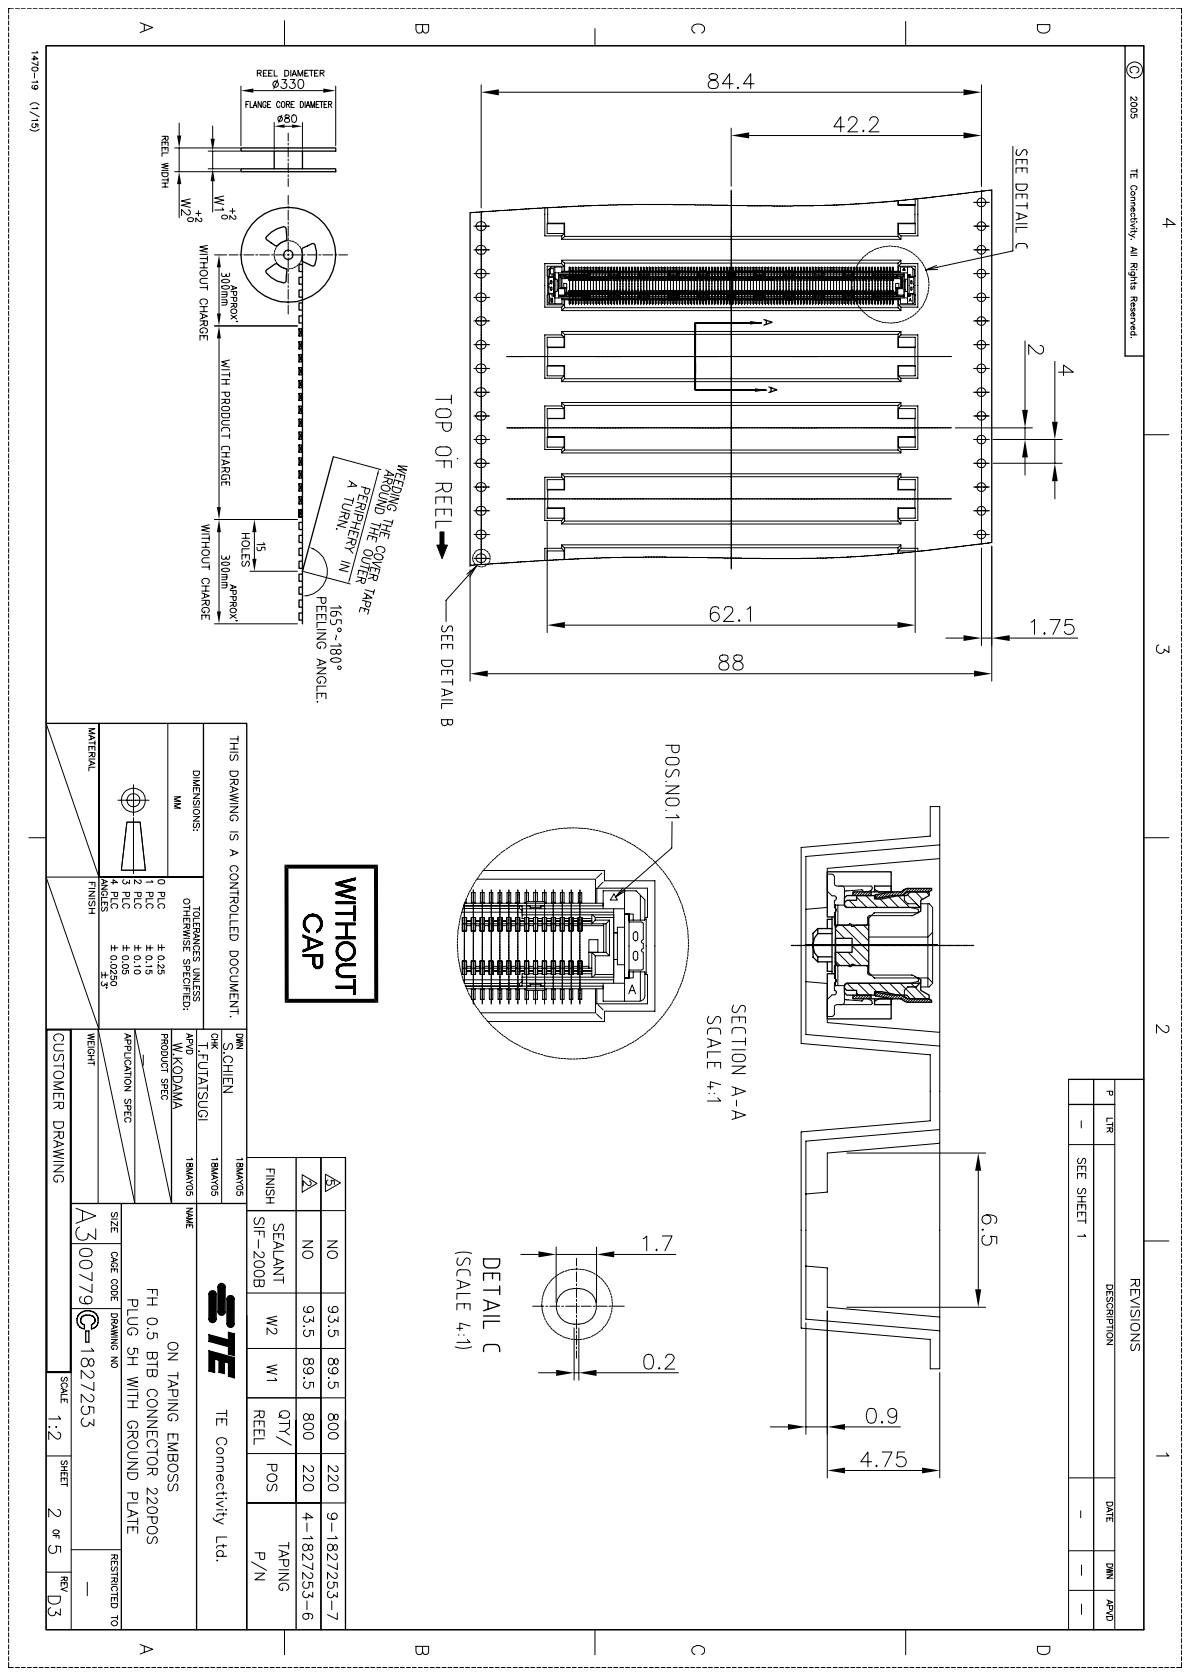
[picture p25: page 2]

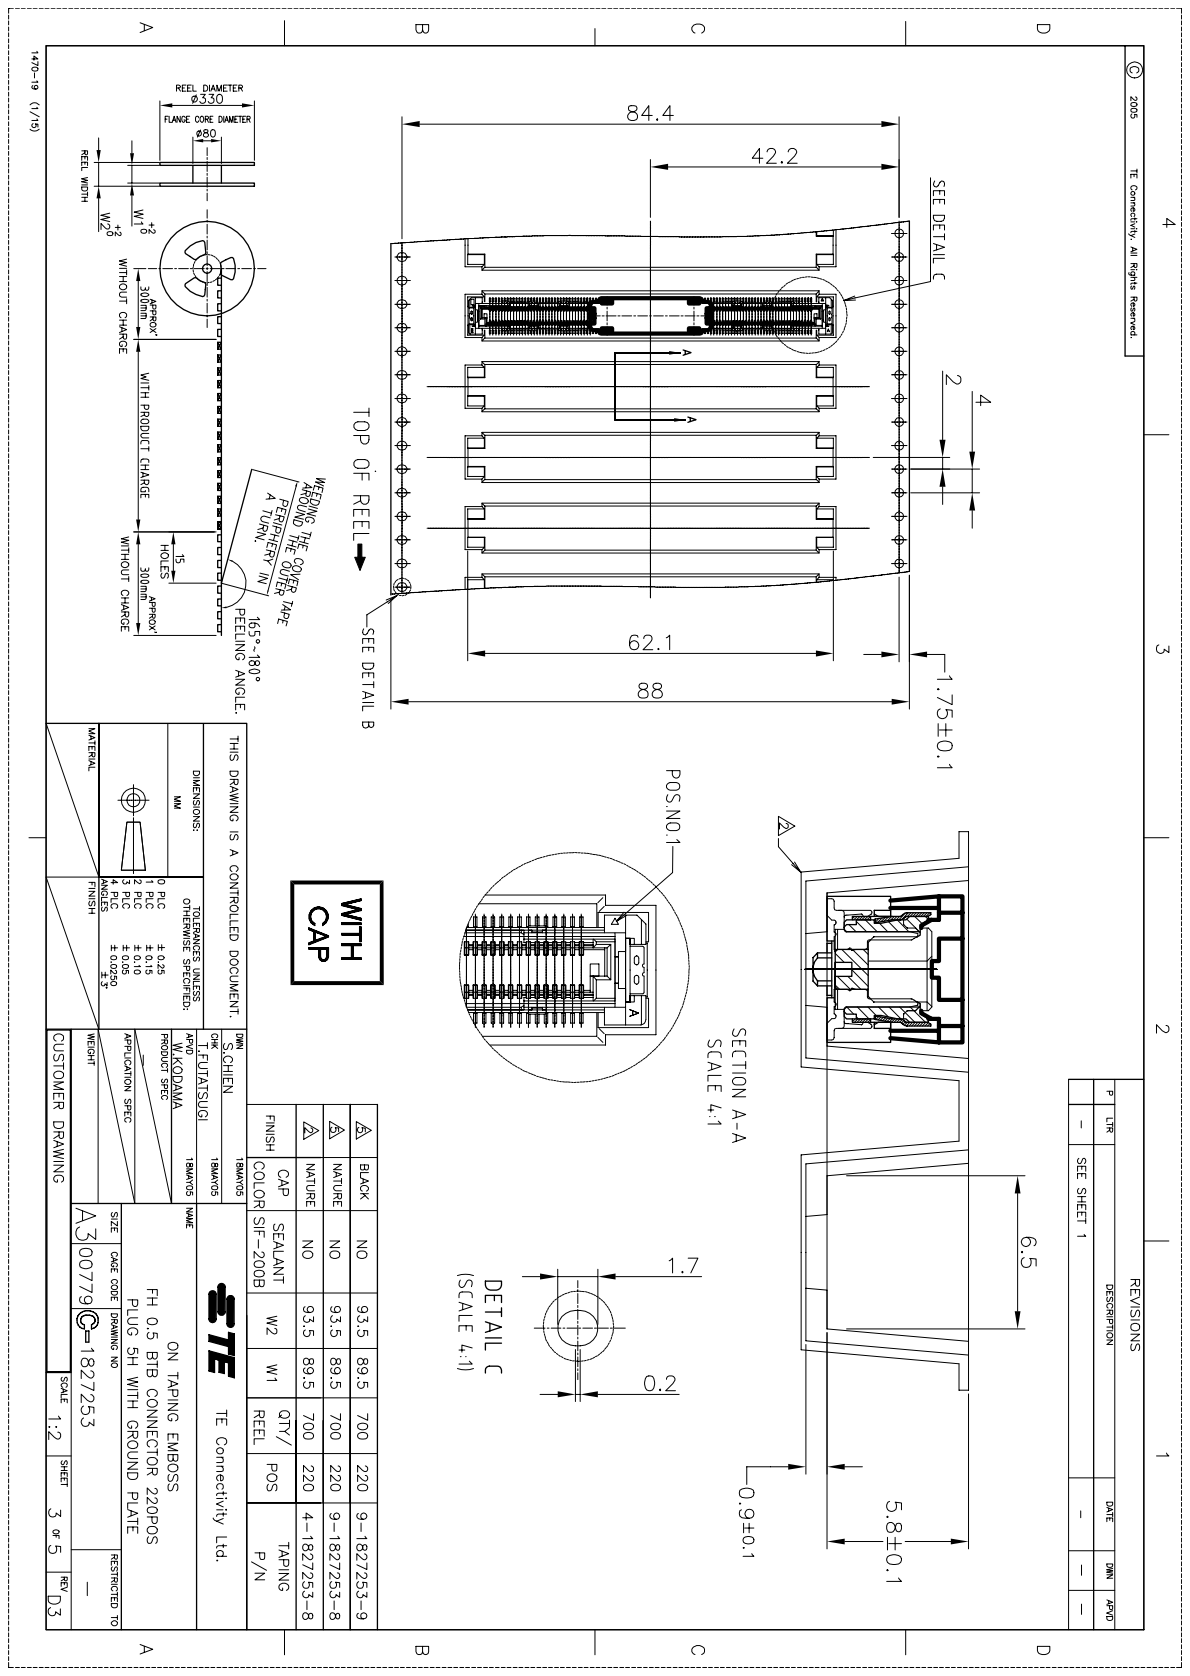
[picture p26: page 3]

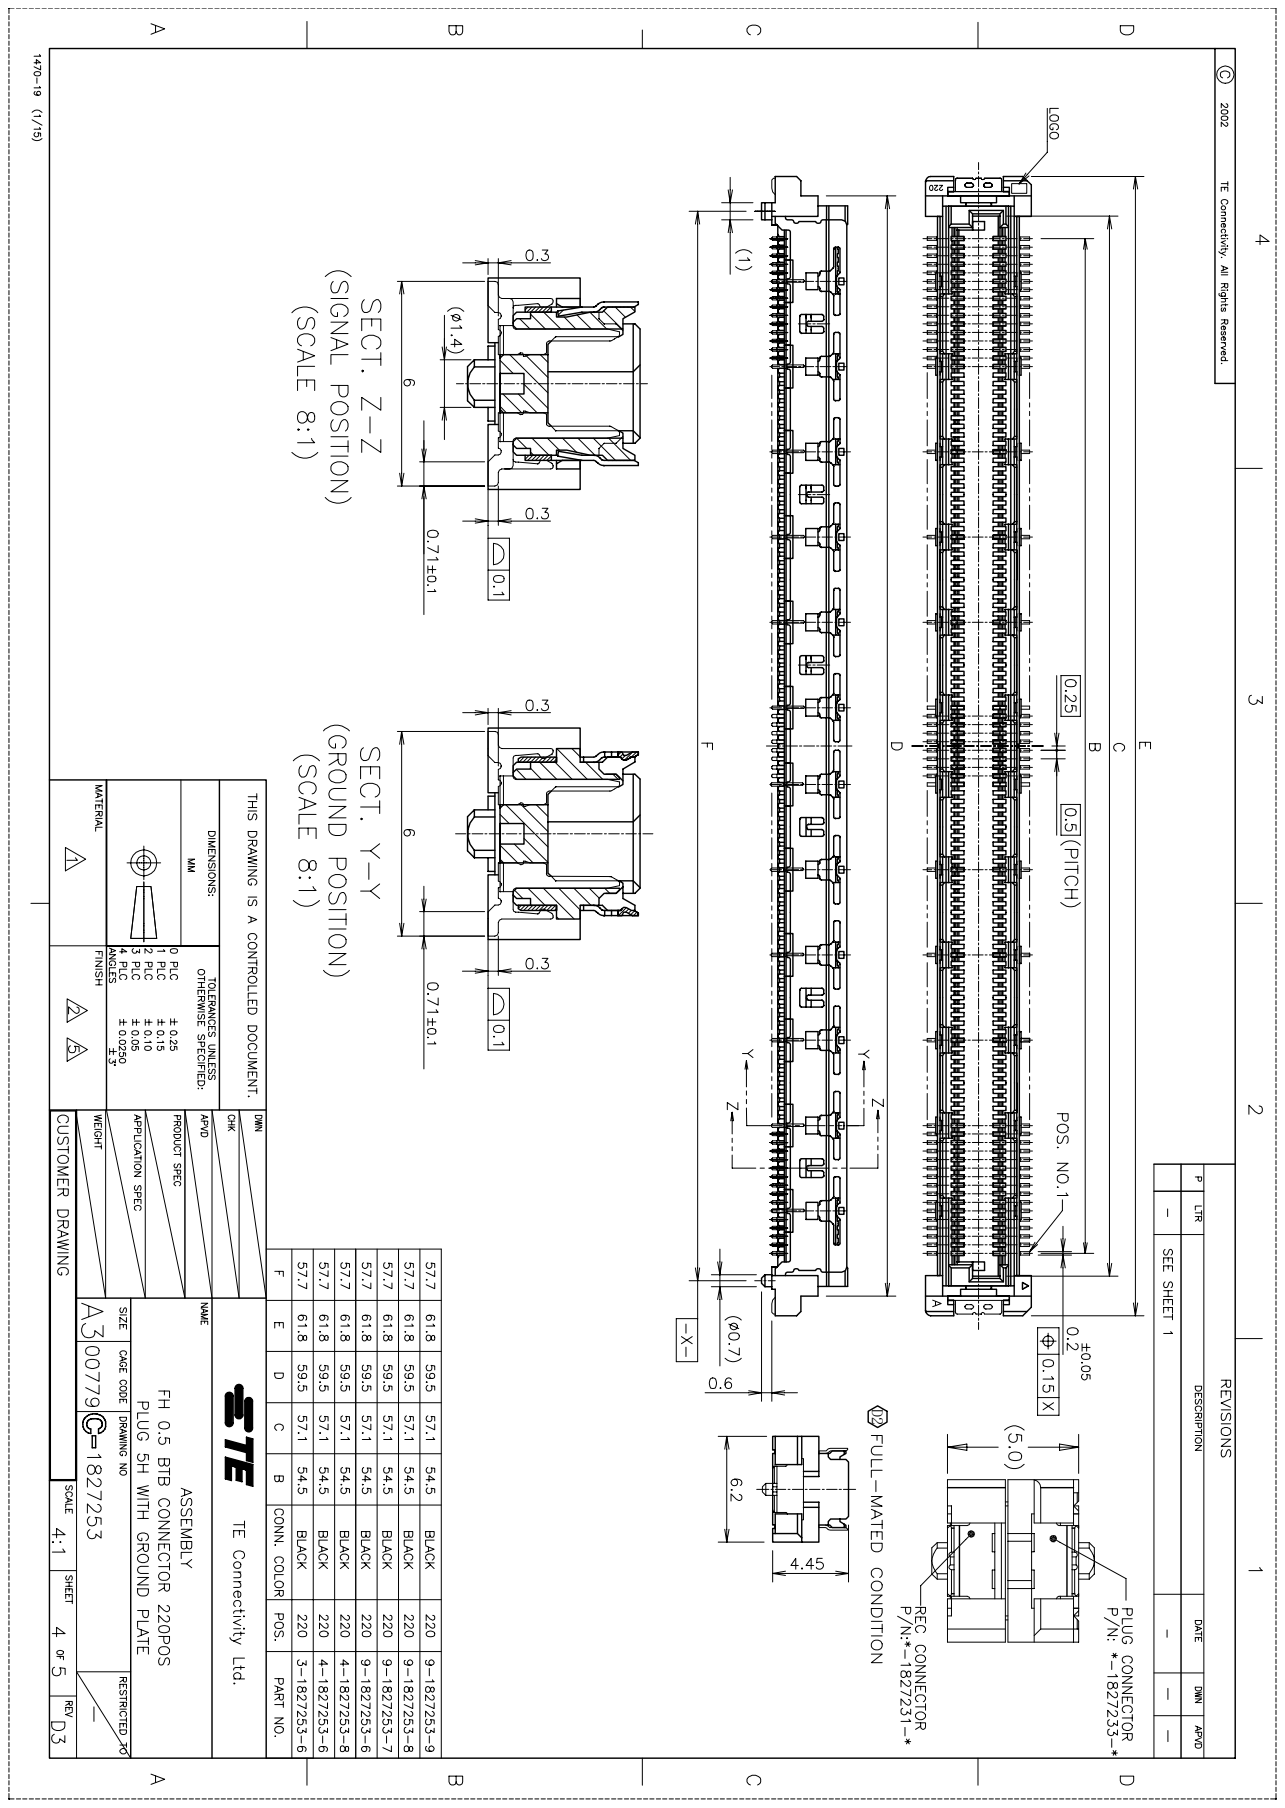
[picture p27: page 4]

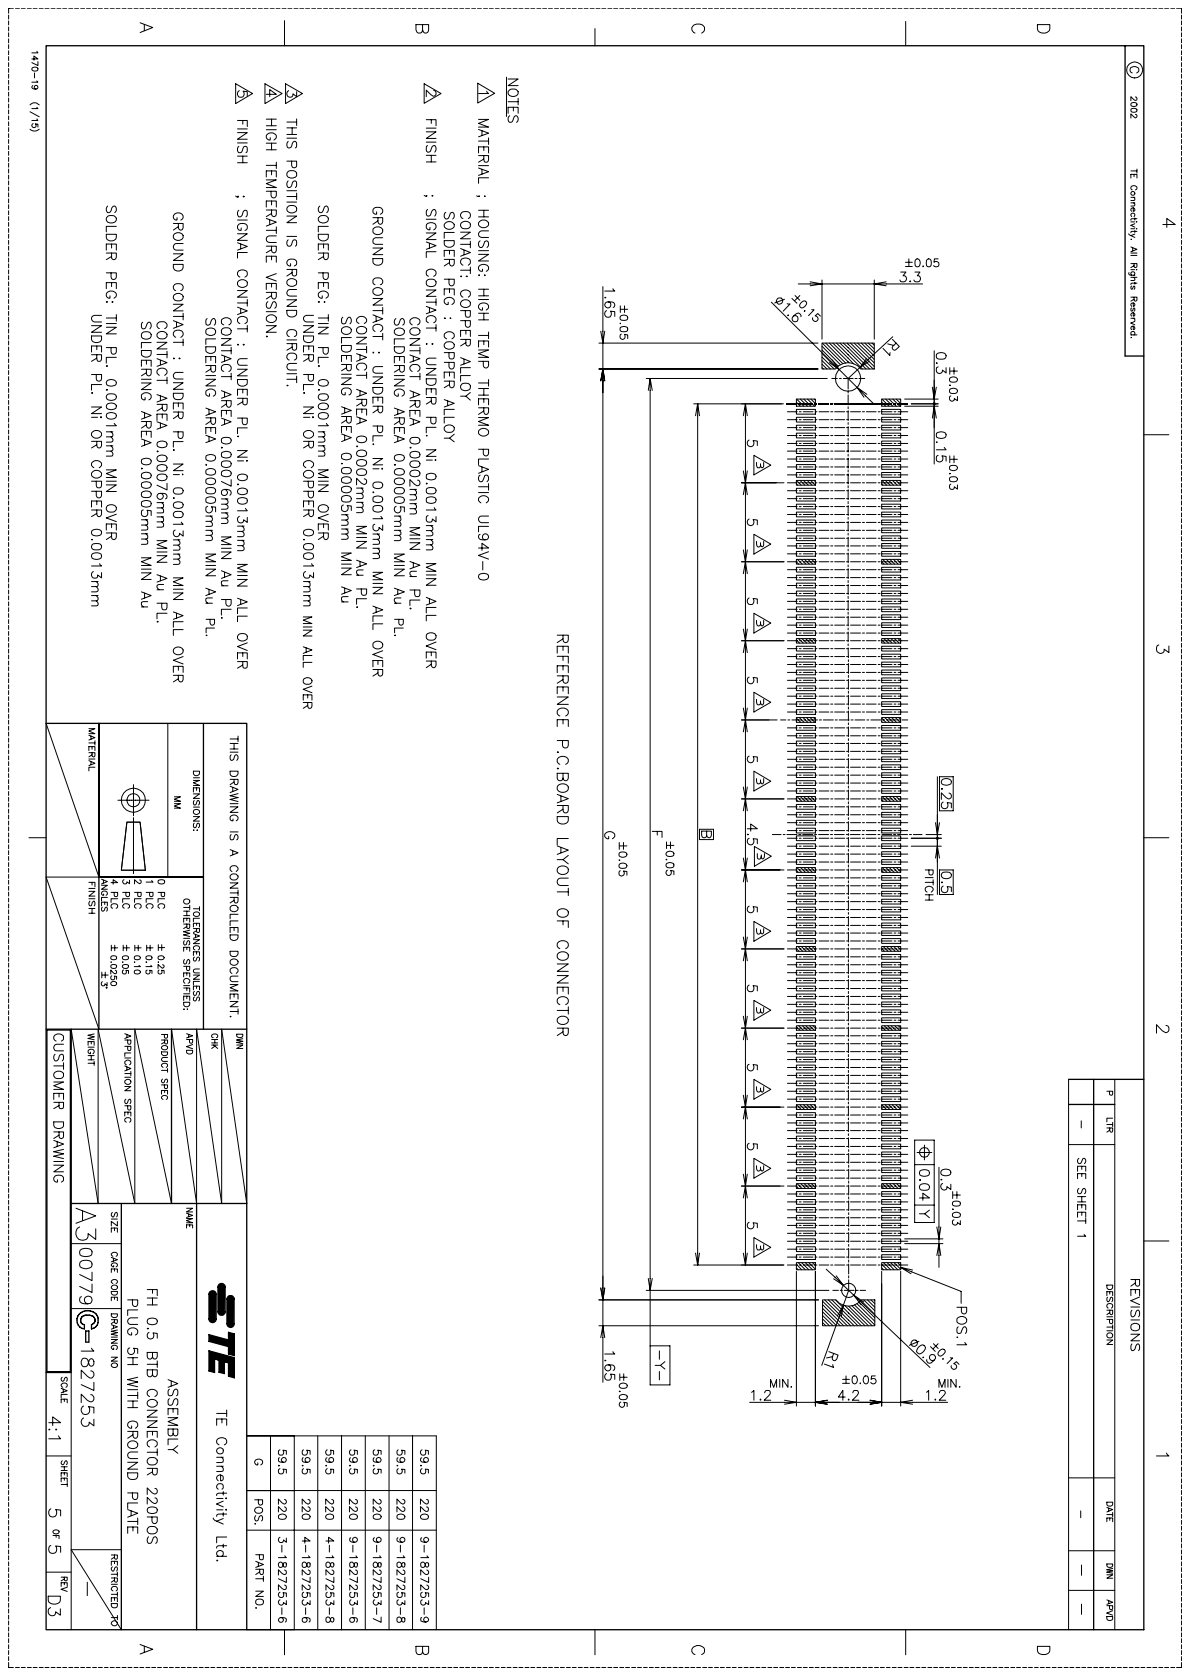
[picture p28: page 5]
