rack-ten-compute/10-inch-homelab-computer/hw/bom/connectors/pcie/x16/WPRS-164AL1B7U-C54930168.pdf

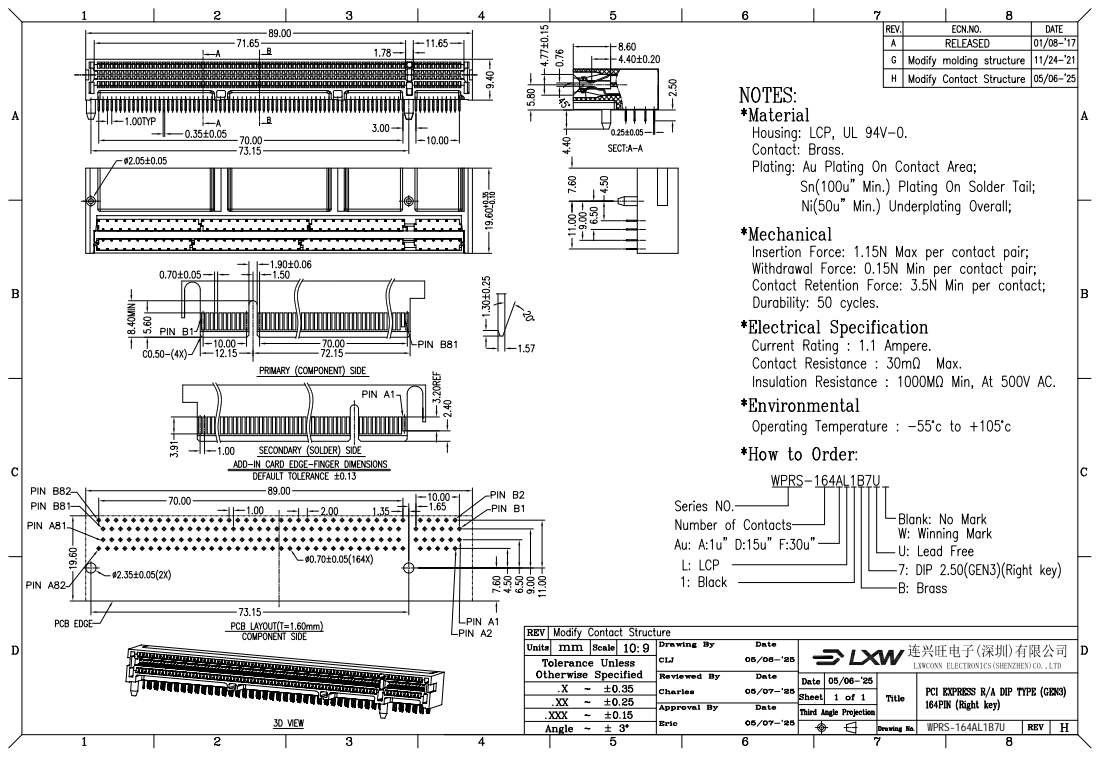
[picture p29: page 1]
WPRS-164AL1B7U
