rack-ten-compute/10-inch-homelab-computer/hw/bom/connectors/pcie/x8/2EG14917-D2D8-4F-C426231.pdf

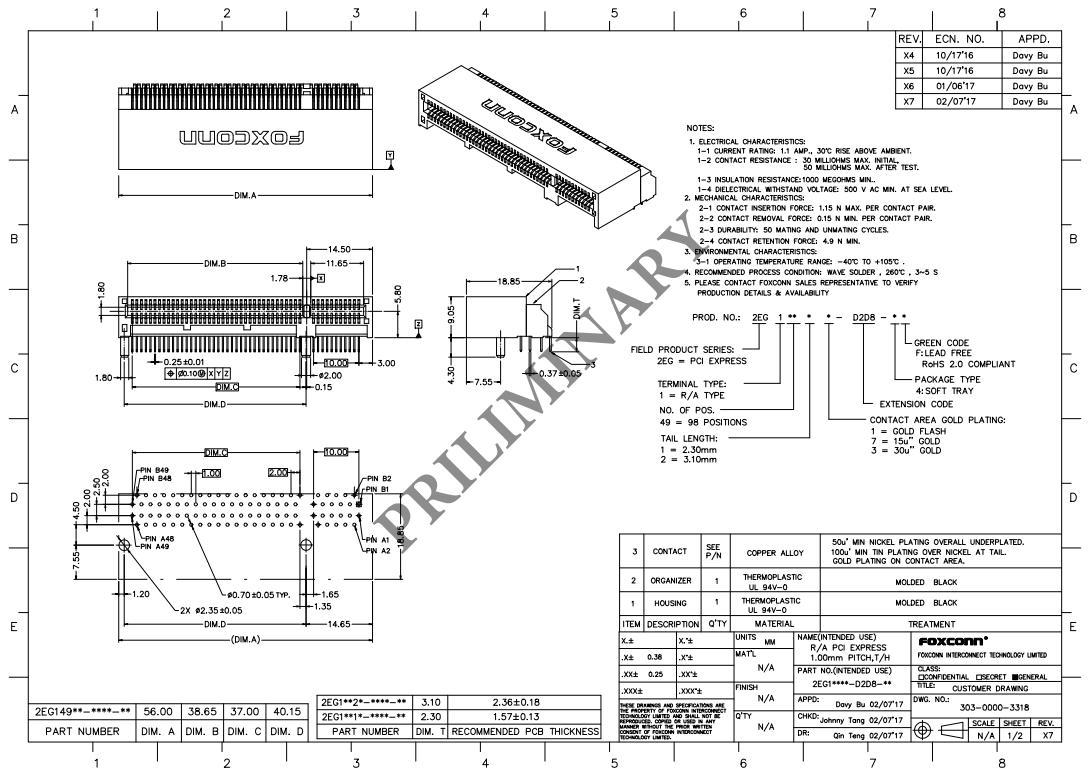
[picture p30: page 1]
PRILIMINARY

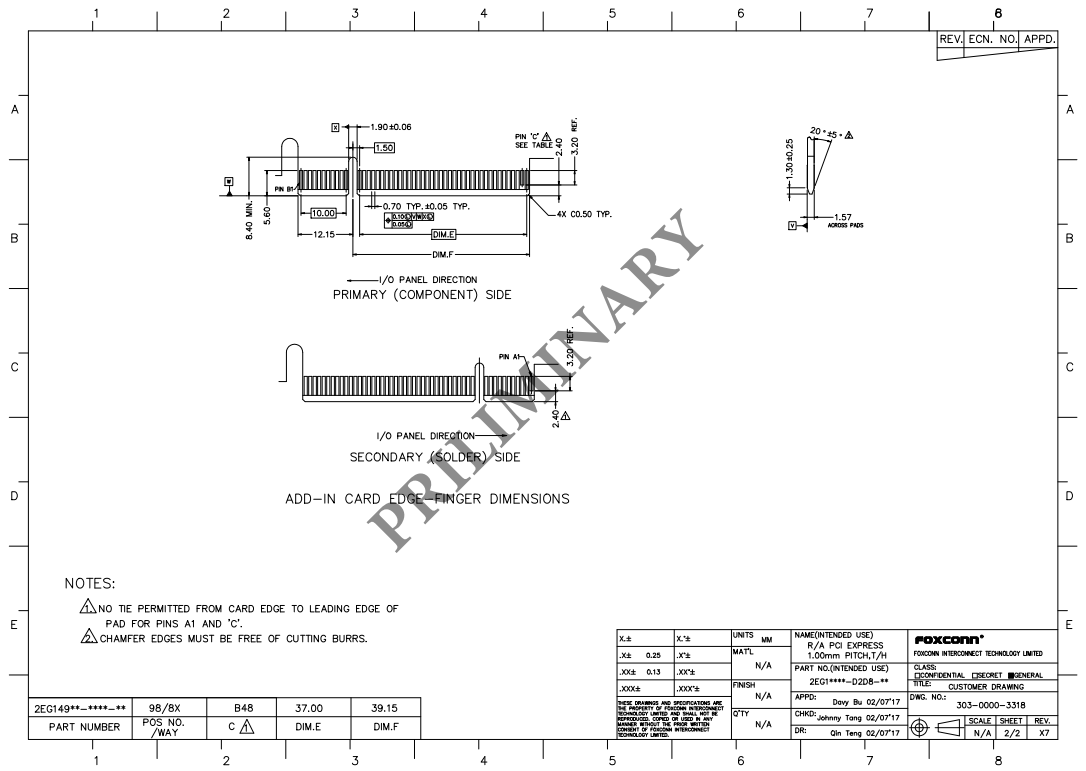
[picture p31: page 2]
PRILIMINARY
