rack-ten-compute/10-inch-homelab-computer/hw/bom/connectors/pcie/x8/3091-10102T-C444346.pdf

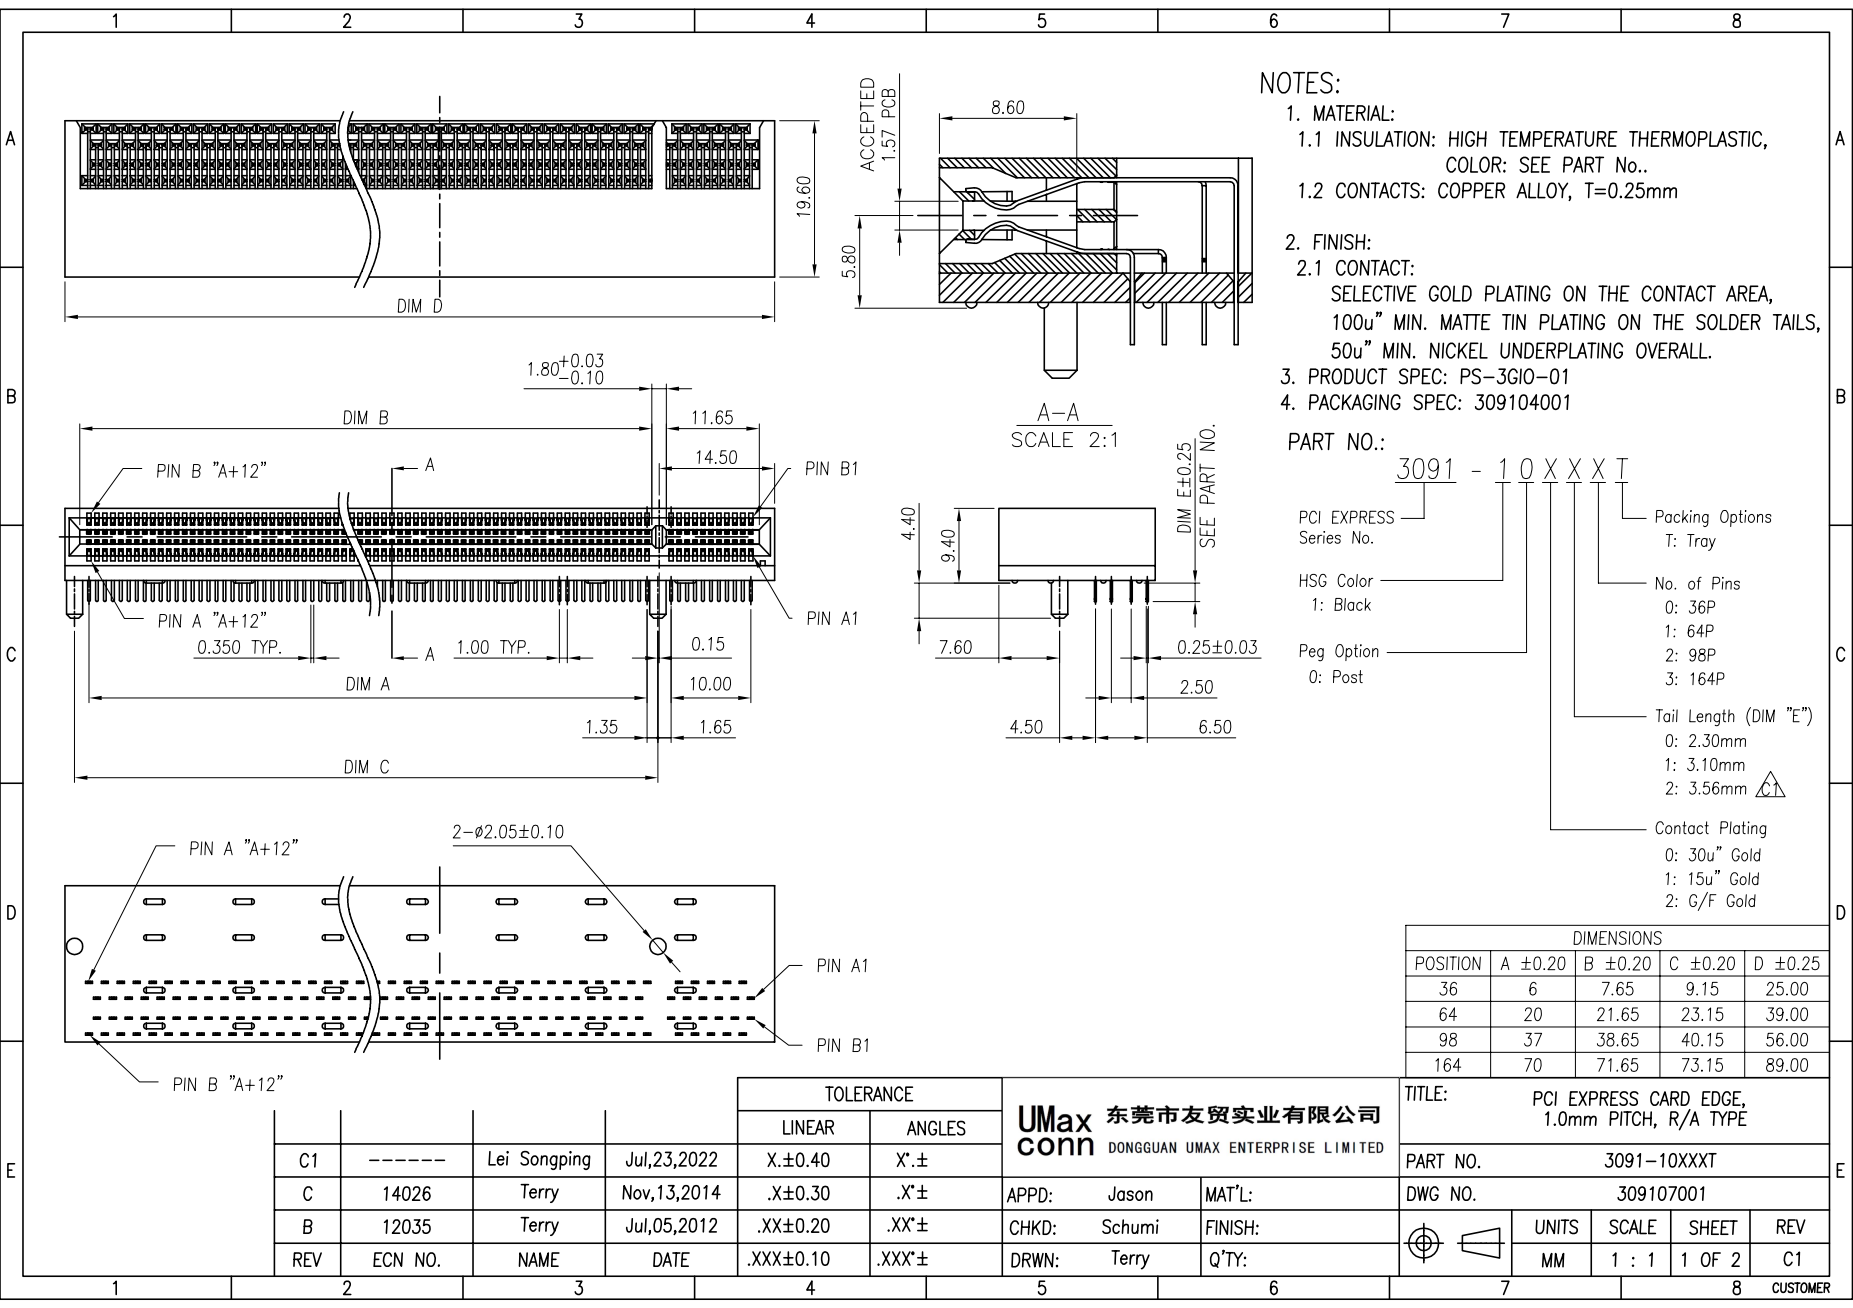
[picture p32: page 1]

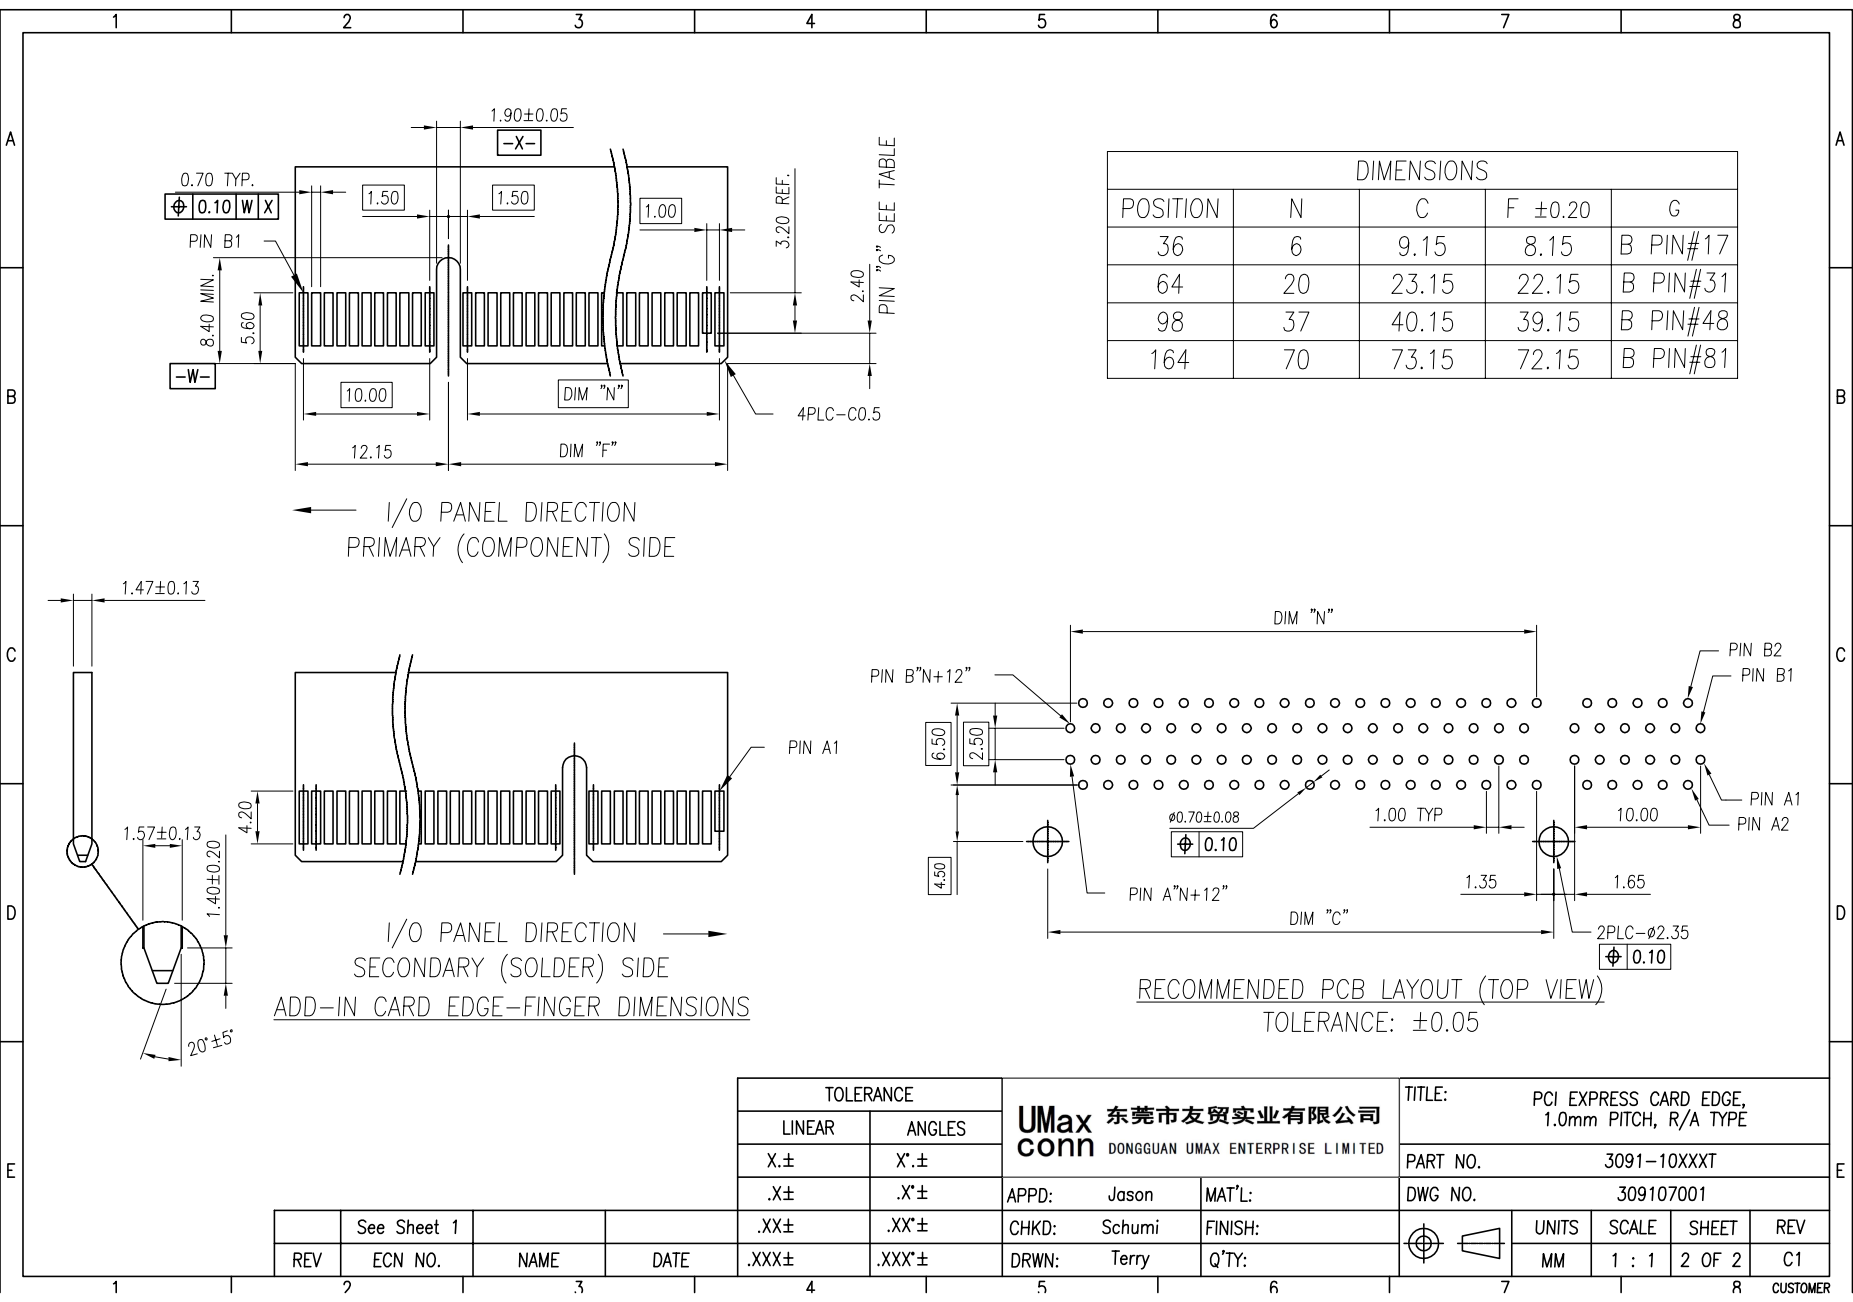
[picture p33: page 2]
