rack-ten-compute/10-inch-homelab-computer/(commit log)

2026-08-05 добавил доки по SOM-5871
    [SOM-5871 A101-3 COME Layout Checklist V1.01 20200604.xlsx]
2026-10-16 Add README.md for connectors with initial content
2026-10-17 docs: add COM Express connector to BOM README
2026-10-17 Add mechanical specifications and images for SOM-5871 Basic Module
    - Introduced a new markdown file for the mechanical specifications of the SOM-5871 Basic Module, detailing dimensions, mounting, and connectors.
    - Included tables for module dimensions, connector specifications, and pin numbering.
    - Added images for the module connector receptacle and PCB patterns for both the module and carrier board.
2026-10-17 Add pinout documentation for SOM-5871 COM Express connector (440 pin)
    This commit introduces a comprehensive pinout table for the SOM-5871 module, detailing the signals, groups, and pin assignments across Rows A, B, C, and D. The documentation is sourced from the official layout checklist and provides essential information for hardware integration and development.
2026-10-17 Добавлена электрическая спецификация для SOM-5871, включая вводное питание, последовательность включения, время нарастания питающих напряжений и требования к целостности сигналов.
2026-10-17 fix: remove typo in description of the SOM-5871 carrier board pin-header
2026-10-17 Add debugging and specification details for SOM-DB5830-00A1 development board
2026-10-17 Add USB interface wiring details and user manual for SOM-5871
2026-10-17 Update USB interface details and clarify connector specifications in documentation
2026-10-18 fix: update USB interface details and clarify pin header specifications in documentation
2026-10-18 fix: update electrical specifications and clarify power modes in documentation
2026-10-18 Add user manuals and cloud mail link documentation for SOM-5871
    - Added SOM-5871_User_Manual_Ed.1-FINAL.pdf
    - Added SOM-5871_User_Manual_Ed.2_FINAL.pdf
    - Created cloud-mail-link.md with relevant links for Win10 driver support
    [SOM-5871 A101-3 COME Layout Checklist V1.01 20200604.xlsx]
2026-10-22 Add connection block diagram for SOM-5871 to README and include SVG file
    - Inserted a new SVG diagram illustrating the connection block for the SOM-5871 module into the README.md file.
    - Added the SVG file 'carrier-board-block-diagram.svg' to the project, detailing the various connections and components of the SOM-5871.
2026-10-22 Add COM Express pinout definition and generation script
    - Created a new markdown file `comexpress-abcd.md` containing the pinout definitions for COM Express A, B, C, and D sides, including signal types and ground references.
    - Added a PowerShell script `gen-comexpress-pinout.ps1` to generate an Excel file from the markdown pinout definitions, organizing the data into separate sheets for each side of the connector.
    [comexpress-abcd-pinout.xlsx]
2026-10-23 feat: update COM Express pinout definitions and remove generation script
    [comexpress-abcd-pinout.xlsx]
2026-10-24 PCIEe x8 / X16 right angle connectors
2026-10-25 docs: move bom/ to hw/bom/ and fix links
2026-10-25 Refactor code structure for improved readability and maintainability
    [SOM-5871.STEP]
2026-10-25 docs: align hw/README.md display + M.2 rows with carrier-board-block-diagram.svg
2026-10-27 docs: update components list in README.md for connectors
