rack-ten-compute/10-inch-homelab-computer/(notices)

Notices in the files:
README.md:
License: MIT
